A123536/final-report/design/basic_mechanical_scheme.md

# V 型直管检测机器人基本机械方案与第二轮仿真

## 1 结论

当前方案在给定边界内可行，可以进入下一阶段的三维结构设计。

相对上一版，本次将目标管径从 180–220 mm 调整为 140–160 mm，连杆轴间距由 200 mm 缩短为 150 mm，机械限位调整为 90°–125°，合成弹簧刚度由 0.026 提高到 0.029 N·m/deg，并把最小轮管摩擦系数降至 0.15，以覆盖干燥光滑不锈钢管。

修订后的二维准静态仿真覆盖了 140–160 mm 管道内径、干燥不锈钢和 PVC 管道、0.15–0.50 轮管摩擦系数、1.4–1.8 kg 整机质量、10 m 管内行程和 15 m 拖线。模型还计入了全向轮28 mm有限宽度对圆管截面的约束。候选机构没有几何奇异点，三个轮子在全部目标管径内保持接触；在最小轮管摩擦系数和保守拖线阻力同时出现时，牵引安全系数为 1.36。20 万组不确定参数扫描未出现负牵引余量。

这一结论表示修订方案通过第二轮几何和受力筛选，不等于完成物理样机验证。下一阶段仍需进行三维干涉检查、弹簧实测和样机管道试验。

## 2 机构布局

机器人采用单关节对称 V 型结构，从侧面观察为：

```text
主动全向轮 A ---- 150 mm 刚性连杆 ---- 中心被动全向轮及弹簧铰链
                                               \
                                                ---- 150 mm 刚性连杆 ---- 主动全向轮 B
```

实际安装姿态为两个主动轮在管道下侧，中心被动轮在管道上侧。这样布置有三个作用：

1. 电机质量直接增加两个主动轮的法向载荷，提高水平直管内的牵引力。
2. 中心轮及弹簧向上压紧管壁，使三个轮子持续接触。
3. 重心位于管轴下方，能够被动恢复竖直姿态，降低全向轮横向滚子导致的绕管轴漂移。

前后电机分别布置在机构纵向中心面的左右两侧，电子元件置于中心面附近，以抵消横向偏载。必要时可在连杆侧面增加不连续接触的低摩擦防翻限位块，但不增加新的承载轮。

## 3 主要尺寸

| 项目 | 初步设计值 |
|---|---:|
| 适配管道内径 | 140–160 mm |
| 全向轮直径 | 60 mm |
| 单根连杆轴间距 | 150 mm |
| 中心 V 角机械限位 | 90°–125° |
| 目标整机质量 | 1.6 kg |
| 允许整机质量上限 | 1.8 kg |
| 目标巡航速度 | 0.15 m/s |
| 首版管内行程 | 10 m |
| 拖线总长 | 15 m |

机械限位对应的理论管径范围约为 129–166 mm，因此目标范围两端均留有角度余量。插入管道前，将机构张开到 125°并用可拔锁销固定，使径向尺寸小于 140 mm；放入管道后拔出锁销，弹簧驱动 V 角减小并压紧管壁。离开管道后，90°限位防止机构突然完全闭合。

### 管径变化下的几何状态

| 管径 | V 型夹角 | 两主动轮轴距 | 含轮外廓总长 |
|---:|---:|---:|---:|
| 140 mm | 118.1° | 257.3 mm | 317.3 mm |
| 150 mm | 108.8° | 243.9 mm | 303.9 mm |
| 160 mm | 98.9° | 227.9 mm | 287.9 mm |

## 4 中心关节和弹簧

中心被动轮与 V 型铰链共轴。轮子通过轴承自由旋转，两根连杆绕同一根中心轴转动。铰链左右两侧各安装一根镜像扭簧，使载荷对称并避免单侧弹簧引起连杆扭转。

弹簧系统目标参数：

| 参数 | 目标值 |
|---|---:|
| 弹簧数量 | 2 根，左右镜像 |
| 单根等效刚度 | 0.0145 N·m/deg |
| 合成刚度 | 0.029 N·m/deg |
| 等效自由角 | 0° |
| 单根最大工作转矩 | 约 1.72 N·m |
| 单根按 1.5 安全系数选型 | 不低于 2.6 N·m |
| 工作角范围 | 约 99°–118° |

这里的 0° 是装配后的等效自由角，可以通过弹簧腿安装孔的索引位置实现，并不强制要求弹簧实物的自由腿夹角为 0°。

仿真得到的合成弹簧转矩为 2.87–3.42 N·m，中心轮压壁力为 50.33–53.24 N。该压壁力约为 5.1–5.4 kgf，能够通过双手压缩并使用锁销完成装入。相比上一版提高压壁力，是为了覆盖较光滑的干燥不锈钢内壁。

## 5 主动轮传动模块

每个主动轮使用一台已选定的 JGB37-520-12100-EN 电机。采用往届模型已有的模数 1、25/40 齿圆柱齿轮构成 1.6:1 外置减速级：

- 电机轴：25 齿、模数 1、φ6 mm D 形孔。
- 轮轴：40 齿、模数 1、φ8 mm 孔。
- 理论中心距：32.5 mm。
- 仿真按 90% 齿轮效率计算。
- 轮轴使用独立的 φ8 mm 钢轴和两只 619/8 轴承支撑，避免将管壁预紧力直接施加到电机减速箱输出轴上。

前后传动模块互为镜像，使两个电机的横向质量相互平衡。齿轮应设置防护罩，避免拖线、灰尘或后续摄像头线束进入啮合区。

### 传动后的性能

| 项目 | 结果 |
|---|---:|
| 轮端空载转速 | 68.75 rpm |
| 理论空载车速 | 0.216 m/s |
| 轮端额定转速 | 53.1 rpm |
| 理论额定车速 | 0.167 m/s |
| 0.15 m/s 时电机转速 | 76.4 rpm |
| 两电机连续理论驱动力 | 28.24 N |

目标巡航速度 0.15 m/s 位于额定速度以内，适合编码器闭环控制，也为后续摄像检查保留降速空间。

## 6 电机驱动器和拖线供电

TB6612 不再作为正式方案。虽然电机额定电流 0.65 A 处于其连续能力内，但单电机堵转电流达到 2.4 A，无法满足可靠堵转保护需求。

正式方案选用双路 MC33926 驱动板：

- 5–28 V 电机电源；
- 每通道约 3 A 连续、5 A 峰值；
- 两个通道分别控制两台电机；
- 带电流检测、过流和过温保护；
- 单台电机 2.4 A 堵转电流位于驱动器连续能力范围内。

参考：[Pololu Dual MC33926 Motor Driver Carrier](https://www.pololu.com/product/1213)。若采购困难，Cytron MDD3A 可作为第二选择，但应另加电流检测。

为减少 15 m 拖线压降，建议在地面端提供 24 V，在机器人端使用 12 V、至少 6 A 的降压模块为电机驱动器供电。控制器和编码器在机器人端处理，只通过 RS-485 沿拖线传输控制与状态数据。这样比直接在长线末端输送 12 V 更适合后续延长行程。

## 7 仿真模型

定义：

- 管道内径为 `D`；
- 轮半径为 `r`；
- 两相邻轮轴之间的连杆长度为 `L`；
- 全向轮宽度为 `w`；
- 单个轮轴相对管道中心的径向偏置为 `z`；
- 中心轮与主动轮中心之间的径向距离为 `h=2z`；
- 单侧轴向跨度为 `a`；
- V 型夹角为 `β`。

几何关系为：

```text
z = sqrt((D/2)^2 - (w/2)^2) - r
h = 2z
a = sqrt(L² - h²)
β = 2 arccos(h/L)
```

合成弹簧转矩为：

```text
M = k(β - β0)
```

忽略连杆自重对局部力矩的小影响，每根连杆关于中心轴的力矩平衡给出：

```text
N_outer × a = M
N_center = 2M/a
```

两个下侧主动轮承担的总法向力近似为：

```text
N_drive = N_center + mg
```

可用牵引力取轮管静摩擦极限与电机连续输出极限中的较小值：

```text
F_traction = min(μ N_drive, F_motor_continuous)
```

拖线阻力按拖入管内的线缆质量和滑动摩擦计算，并叠加机器人滚动阻力。材料工况采用保守区间，而不是把某个手册摩擦系数当作固定值：

- 干燥不锈钢管按 `μ=0.15–0.30` 检查，其中 0.15 为光滑表面的设计下限；
- 干燥 PVC 管按 `μ=0.25–0.50` 检查；
- 全局不确定性扫描使用 `μ=0.15–0.50`。

实际摩擦系数会随全向轮滚子材料、表面粗糙度和灰尘变化，样机阶段必须通过斜坡法或拉力计实测。保守工况使用：

- 轮管摩擦系数 0.15；
- 拖线线密度 0.12 kg/m；
- 拖线摩擦系数 0.5；
- 机器人滚动阻力系数 0.08；
- 整机质量 1.8 kg；
- 管内拖线长度 10 m。

## 8 第二轮仿真结果

### 接触与牵引

| 项目 | 结果 |
|---|---:|
| 中心轮压壁力 | 50.33–53.24 N |
| μ=0.15 时最小可用牵引力 | 9.90 N |
| 10 m 标称总阻力 | 3.53 N |
| 10 m 保守总阻力 | 7.30 N |
| 标称安全系数 | 2.70 |
| 保守安全系数 | 1.36 |
| 标称单电机估算电流 | 0.22 A |
| 保守单电机估算电流 | 0.30 A |

最不利工况下，牵引力主要受轮管摩擦限制，而不是受电机额定转矩限制。正常匀速运行时电机电流远低于 0.65 A 额定值。启动阶段仍应采用约 1 s 的 PWM 斜坡，防止全向轮瞬时打滑。

### 不确定性扫描

使用 20 万组随机参数进行扫描：

- 管径 140–160 mm；
- 整机质量 1.4–1.8 kg；
- 轮管摩擦系数 0.15–0.50；
- 弹簧刚度误差 ±10%；
- 等效自由角误差 0–5°；
- 拖线线密度 0.05–0.12 kg/m；
- 拖线摩擦系数 0.2–0.5；
- 滚动阻力系数 0.03–0.08。

结果：

- 牵引余量大于零的比例：100%；
- 安全系数不低于 1.2 的比例：100%；
- 安全系数不低于 1.5 的比例：99.995%；
- 安全系数第 1 百分位：2.04；
- 最小抽样牵引余量：2.77 N。

## 9 第二轮判定

| 检查项 | 判定 |
|---|---|
| 140–160 mm 管径几何适应 | 通过 |
| V 角限位余量 | 通过 |
| 三轮持续压壁 | 通过 |
| 最小摩擦工况牵引 | 通过 |
| 干燥不锈钢保守摩擦下限 | 通过，按 μ=0.15 |
| 干燥 PVC 工况 | 通过，牵引余量高于不锈钢工况 |
| 10 m 保守拖线阻力 | 通过，安全系数 1.36 |
| 电机连续转矩 | 通过，存在明显余量 |
| 电机额定速度 | 通过，传动后约 0.167 m/s |
| 电机驱动器 | TB6612 否决；MC33926 通过 |
| 横向防翻 | 通过布置原则控制，待三维模型确认 |
| 真实弹簧参数 | 待选型和台架实测 |
| 真实管材摩擦 | 已覆盖不锈钢/PVC保守区间，仍需样机实测 |

## 10 尚未开始的下一阶段

本轮只确定了基本机械架构和参数可行性，尚未开始三维零件设计。下一阶段应依次完成：

1. 确定 φ60 全向轮的实际宽度、轮毂孔和滚子材料。
2. 完成中心轮、双扭簧、锁销和机械限位的详细结构。
3. 完成 25/40 齿传动模块及 φ8 轮轴轴承支撑。
4. 在 140 mm 管径下检查电机、齿轮、轮子和外壳的三维包络，横向结构宽度目标不超过 95 mm。
5. 采购或制作弹簧后进行角度－转矩标定。
6. 制作样机并按 140、150、160 mm 三种管径，以及不锈钢和 PVC 两种材料完成牵引和 10 m 行走试验。

## 11 仿真文件

- `simulation/v_pipe_robot_sim.py`：可重复运行的计算脚本。
- `simulation/results/summary.json`：汇总结果。
- `simulation/results/diameter_sweep.csv`：完整管径扫描数据。
- `simulation/results/geometry_and_preload.png`：角度、长度、弹簧转矩与压壁力。
- `simulation/results/geometry_snapshots.png`：三种管径的机构姿态。
- `simulation/results/traction_and_tether.png`：牵引力与拖线阻力。
- `simulation/results/monte_carlo_robustness.png`：20 万组不确定参数扫描。
