A123536/final-report/cad/solidworks/model/HARNESS_PART_MAPPING.txt

Corrected generated harness part names; geometry and transforms are unchanged.
POWER: diameter 4.4 mm; segment lengths 115.6, 61.0, 60.4, 93.3 mm.
SIGNAL: diameter 3.2 mm; segment lengths 114.4, 64.4, 64.1, 93.3 mm.
