A123536/final-report/cad/outputs/annotated_side_layout.png

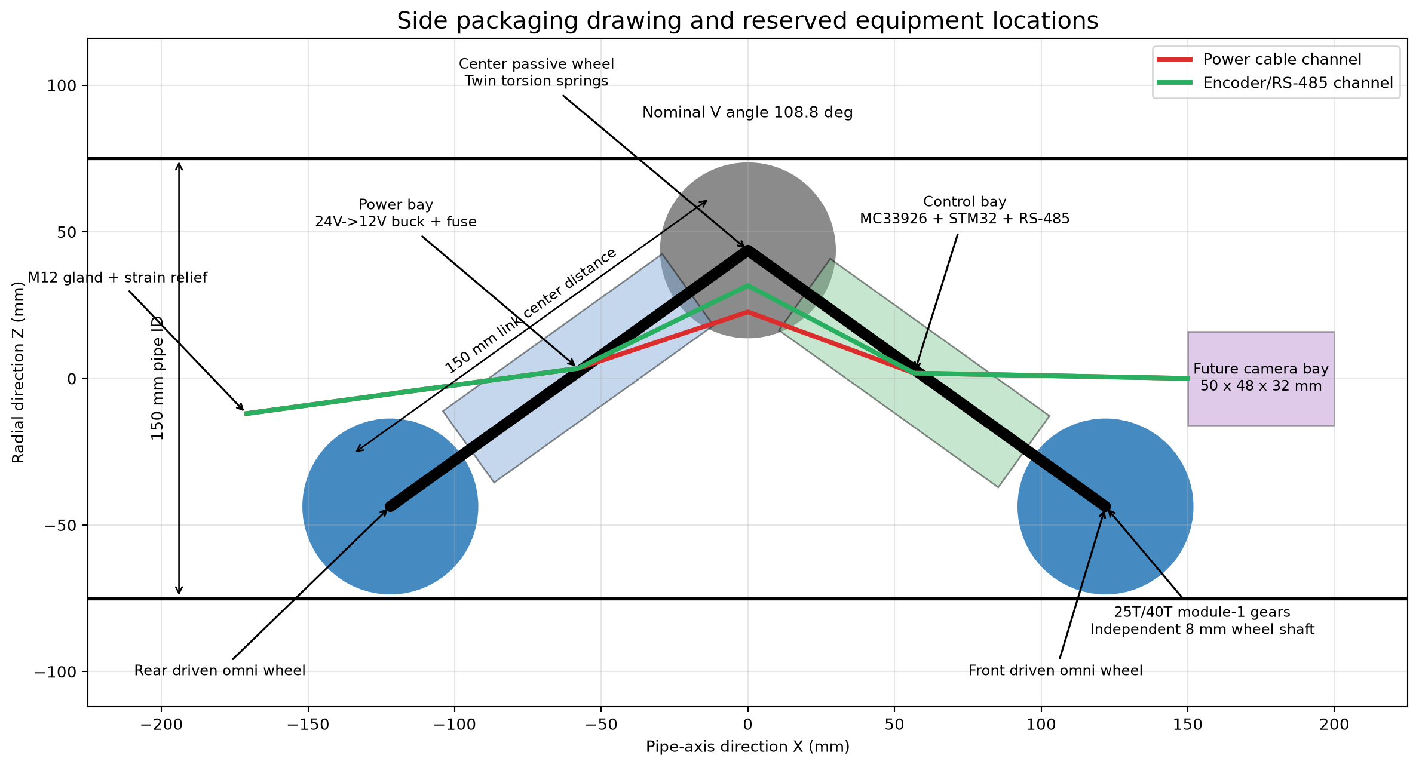
cad/outputs/annotated_side_layout.png
