A123536/final-report/cad/outputs/cross_section_clearance.png

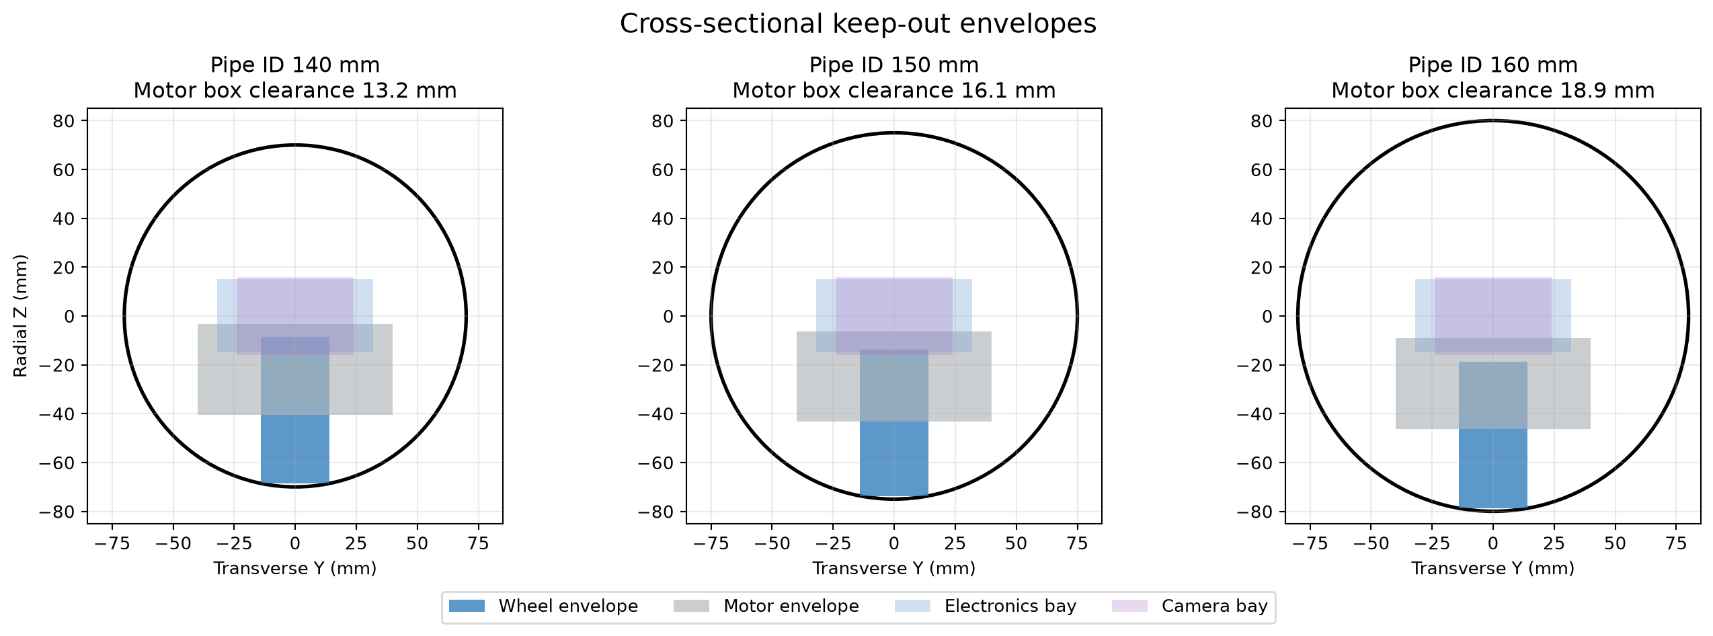
cad/outputs/cross_section_clearance.png
