A123536/final-report/cad/solidworks/model/general_arrangement.png

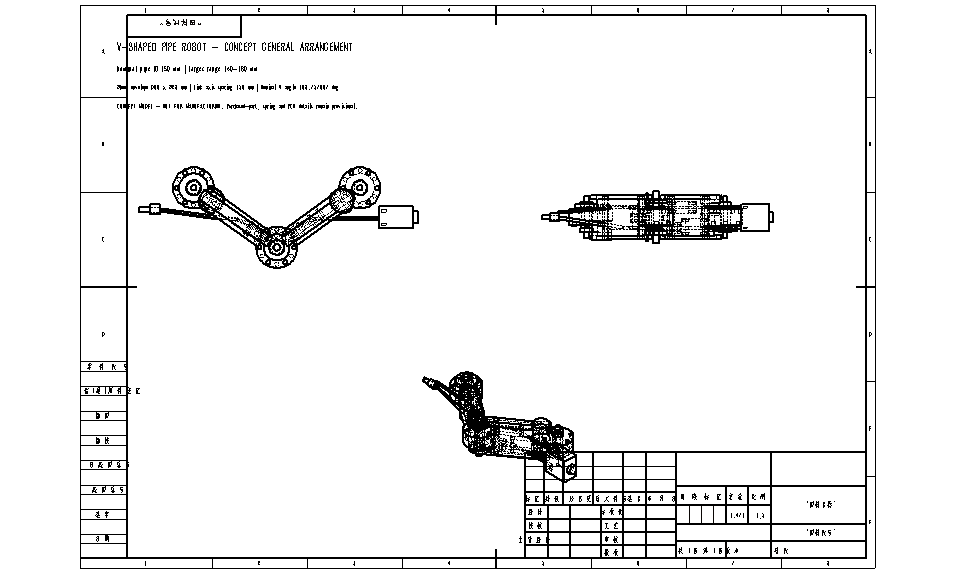
cad/solidworks/model/general_arrangement.png
