A123536/final-report/cad/solidworks/model/overview_robot_only.png

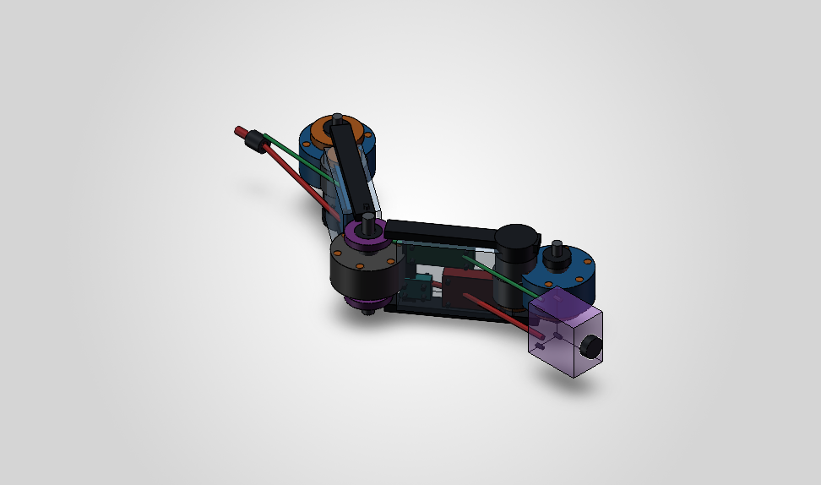
cad/solidworks/model/overview_robot_only.png
