A123536/final-report/cad/solidworks/model/overview_with_pipe.png

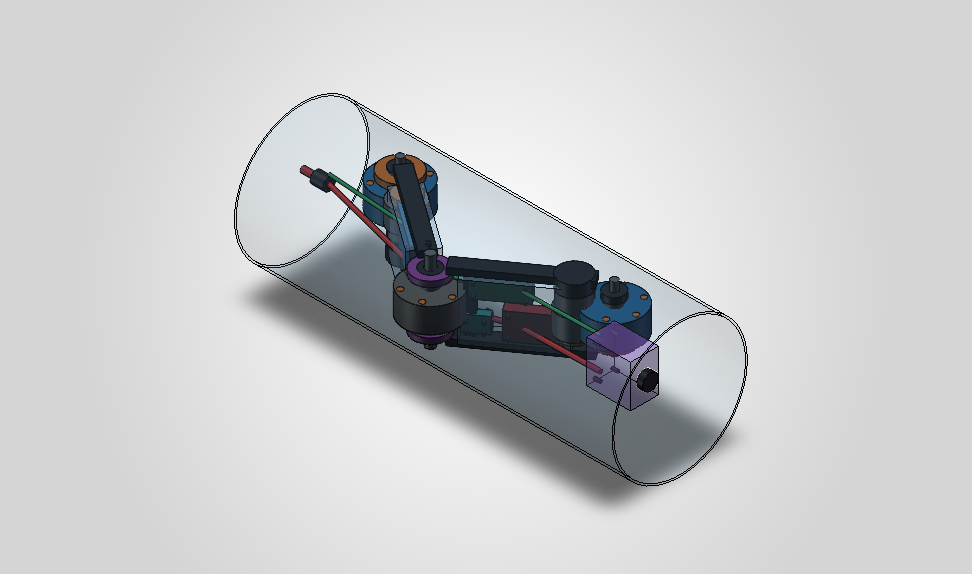
cad/solidworks/model/overview_with_pipe.png
