A123536/final-report/outputs/01a12b65-609a-7bf2-be3d-549e726e3b11/V型管道机器人_完整采购清单_含视觉_2026-10-28.xlsx

Sheet: 采购清单
V型管道机器人完整采购清单（含视觉）
核对日期 | 2026-10-28T00:00:00.000Z |  | 用途：电脑实时看画面、拍照录像，并预留电脑端识别
主购：F411 + MC33926；Luckfox Pico Max + SC3336(B)经有线以太网图传。相机舱须按实物重新设计。
现在买 | 51 | 先确认 | 14 | 图纸后加工 | 13 | 可选 | 9
项目种类 | 87 |  | 已填报价合计（元，非完整预算） | 0.00 |  | 未填单价 | 87
浅黄色列可编辑。已备数量暂填0用于计划，并非实物盘点。报价未填时小计留空，所有型号的现货与到手价均需向商家确认。
编号 | 模块 | 器材 | 推荐型号 / 规格 | 装机用量 | 建议采购 | 已备数量 | 待购数量 | 单位 | 采购阶段 | 采购状态 | 单价（元） | 小计（元） | 关键规格 | 适配与下单说明 | 来源名称 | 厂家资料链接
E01 | 电控 | 运动主控板 | WeAct MiniF4 STM32F411CEU6 V3.1 | 1 | 2 | 0 | 2 | 块 | 现在买 | 未下单 |  |  | 100MHz、3.3V逻辑；整块开发板，不买裸芯片 | 一块装机一块备件；核对F411CE与板上Flash占用 | WeAct MiniSTM32F4x1官方仓库 | https://github.com/WeActStudio/WeActStudio.MiniSTM32F4x1
E02 | 电控 | 双路有刷电机驱动 | Pololu Dual MC33926 Motor Driver Carrier #1213 | 1 | 1 | 0 | 1 | 块 | 现在买 | 未下单 |  |  | 5–28V；约3A连续/路、5A短时峰值；3–5V逻辑 | 约45.7×27.9mm PCB；勿买Arduino/RPi大盾板；封壳需温升测试 | Pololu Dual MC33926 #1213 | https://www.pololu.com/product/1213
E03 | 电控 | STM32下载调试器 | STLINK-V3MINIE 原装 | 1 | 1 | 0 | 1 | 个 | 现在买 | 未下单 |  |  | SWD；USB-C；带STDC14排线 | 若已有可用SWD调试器可扣减；不是量产烧录座 | STLINK-V3MINIE官方资料 | https://www.st.com/en/development-tools/stlink-v3minie.html
E04 | 电控 | SWD转接线 | STDC14 1.27mm转2.54mm SWD转接板/线 | 1 | 1 | 0 | 1 | 套 | 现在买 | 未下单 |  |  | 引出SWDIO/SWCLK/GND/VTref/NRST | 与V3MINIE和MiniF4实际接口核对 | STLINK-V3MINIE官方资料 | https://www.st.com/en/development-tools/stlink-v3minie.html
E05 | 电控 | 机器人RS485收发器 | Waveshare RS485 Board (3.3V)，SP3485 | 1 | 2 | 0 | 2 | 块 | 现在买 | 未下单 |  |  | 3.3V供电与逻辑；显式DE/RE控制 | 一装一备；实测PCB、接线端子高度后调整小板位置 | Waveshare SP3485 3.3V板 | https://www.waveshare.com/rs485-board-3.3v.htm
E06 | 电控 | 电脑USB转RS485 | Waveshare USB TO RS485/422 隔离版 | 1 | 1 | 0 | 1 | 个 | 现在买 | 未下单 |  |  | 二线半双工RS485、隔离电源与信号 | 放在管外；不买RS232冒充RS485；无需再加第二只板做电脑端 | Waveshare隔离USB转RS485/422 | https://www.waveshare.com/wiki/USB_TO_RS485/422
E07 | 电控 | 编码器电平转换 | SN74LVC245A 3.3V转换模块 | 1 | 1 | 0 | 1 | 块 | 现在买 | 未下单 |  |  | 3.3V供电、输入容忍5.5V；至少4路单向 | 先测编码器是推挽还是开漏，再确定接法；不能直接假设5V信号可进所有F411脚 | TI SN74LVC245A | https://www.ti.com/product/SN74LVC245A
E08 | 电控 | USB数据线 | USB-A/USB-C至USB-C，带数据功能 | 2 | 3 | 0 | 3 | 根 | 现在买 | 未下单 |  |  | 短线0.5–1m，供烧录/调试 | 匹配电脑接口；不是15m图传主线 | 本仓库机械/外壳方案 Rev C
E09 | 电控 | RS485终端电阻 | 120Ω、0.25W、1% | 2 | 10 | 0 | 10 | 只 | 现在买 | 未下单 |  |  | 总线物理两端各一只 | 先核对模块内置终端；已有的不能再重复并联 | 本仓库机械/外壳方案 Rev C
E10 | 电控 | 控制载板 | 2.54mm小型洞洞板/定制载板 | 1 | 2 | 0 | 2 | 块 | 现在买 | 未下单 |  |  | 可裁切；装机必须焊接固定 | 先板卡台架验证，再确定载板尺寸与安装孔 | 本仓库机械/外壳方案 Rev C
M01 | 动力传动 | 编码减速电机 | Hiwonder JGB37-520R90-12，带AB编码器 | 2 | 2 | 0 | 2 | 台 | 现在买 | 未下单 |  |  | 12V、90:1、110rpm空载、约85rpm额定、φ6偏心D轴 | 官方版本堵转3.2A，额定转矩2.6kg·cm；不同于旧2.4A假设，必须重定限流/保护并实测安装尺寸 | Hiwonder JGB37-520官方参数 | https://www.hiwonder.com/products/hall-encoder-dc-geared-motor
M02 | 动力传动 | 电机配套6芯线束 | 与所购JGB37编码器配套的原厂插头线 | 2 | 4 | 0 | 4 | 根 | 现在买 | 未下单 |  |  | 2电机线+编码器VCC/GND/A/B | 随电机买；让卖家提供线序/间距，勿凭6芯就盲买JST-PH | Hiwonder JGB37-520官方参数 | https://www.hiwonder.com/products/hall-encoder-dc-geared-motor
M03 | 动力传动 | φ60普通全向轮 | 定制90°全向轮：φ60、轮体宽≤28、φ8轮毂适配 | 3 | 3 | 0 | 3 | 只 | 先确认 | 未下单 |  |  | PU/橡胶滚子；单轮允许径向载荷≥80N约8kgf | 中心轮约53N，按1.5余量询价；现未核实可直接替换商品；不买45°麦克纳姆轮，也不买仅3kg承载Nexus14145 | 航发90度全向轮系列；询问定制，不宣称有直接适配型号 | https://hangfa.com/zh/products/wheels
M04 | 动力传动 | φ8夹紧轮毂 | φ8夹紧式轮毂，法兰孔型按实际全向轮 | 3 | 3 | 0 | 3 | 只 | 先确认 | 未下单 |  |  | 两主动轮传扭，一被动轮连接；匹配轮芯/轴承布置 | 外径、总轴向长度和螺孔未定；不能按旧18×36包络直接认定市售件适配 | 本仓库机械/外壳方案 Rev C
M05 | 动力传动 | 电机25齿齿轮 | m=1、z=25、20°直齿、φ6 D孔、有效齿宽7mm | 2 | 2 | 0 | 2 | 只 | 图纸后加工 | 未下单 |  |  | 建议45钢；毂部尺寸配合电机实际轴伸 | KHK等标准齿轮只能作齿形参照；带长轮毂/10mm齿宽件不能直接塞入现包络 | 本仓库机械/外壳方案 Rev C
M06 | 动力传动 | 25齿惰轮 | m=1、z=25、20°直齿、φ6孔、有效齿宽7mm | 2 | 2 | 0 | 2 | 只 | 图纸后加工 | 未下单 |  |  | 与M05/M07同模数压力角；独立φ6轴和686轴承 | 惰轮在轴上如何转动、轴承装在何处必须由制造图确定 | 本仓库机械/外壳方案 Rev C
M07 | 动力传动 | 40齿轮轴齿轮 | m=1、z=40、20°直齿、φ8孔、有效齿宽7mm | 2 | 2 | 0 | 2 | 只 | 图纸后加工 | 未下单 |  |  | 与轴的夹紧/键/止动结构按图确定 | 轴距25.0与32.5mm；齿宽7mm不是含轮毂总宽 | 本仓库机械/外壳方案 Rev C
M08 | 动力传动 | 主轴轴承 | 619/8-2RS1（SKF）或同尺寸698-2RS | 6 | 8 | 0 | 8 | 只 | 现在买 | 未下单 |  |  | 8×19×6mm，双面密封 | 核对实测三维尺寸；不能替换为608的8×22×7mm | SKF轴承目录：619/8=8×19×6 | https://www.skf.com/binaries/pub12/Images/0901d196802809de-Rolling-bearings---17000_1-EN_tcm_12-121486.pdf
M09 | 动力传动 | 惰轮轴承 | 686-2RS，正规轴承商 | 2 | 4 | 0 | 4 | 只 | 现在买 | 未下单 |  |  | 6×13×5mm | 当前概念每惰轮1只；若制造图改双支撑，用量变4只，备量已覆盖 | 本仓库机械/外壳方案 Rev C
M10 | 动力传动 | φ8轮轴/中心轴 | 45钢精磨轴，按制造图车削 | 3 | 3 | 0 | 3 | 根 | 图纸后加工 | 未下单 |  |  | 概念长74mm×2、92mm×1；轴径8mm | 这些是包络长度；挡圈槽、轴肩、配合公差和最终长度尚不能下加工单 | 本仓库机械/外壳方案 Rev C
M11 | 动力传动 | φ6惰轮轴 | 45钢精磨轴，按制造图车削 | 2 | 2 | 0 | 2 | 根 | 图纸后加工 | 未下单 |  |  | 概念φ6×14mm | 螺纹/止动端和配合待图纸；不要用普通长螺丝光杆替代精密轴颈 | 本仓库机械/外壳方案 Rev C
M12 | 动力传动 | 薄壁轴向调整垫片 | φ8内孔，0.2/0.5/1.0mm混合 | 12 | 30 | 0 | 30 | 片 | 先确认 | 未下单 |  |  | 各厚度10片；外径不碰轴承密封圈 | 确认轴肩与轴承内圈接触后使用 | 本仓库机械/外壳方案 Rev C
M13 | 动力传动 | φ8轴端挡圈 | DIN471 φ8轴用挡圈 | 6 | 20 | 0 | 20 | 只 | 先确认 | 未下单 |  |  | 与最终槽宽/槽径匹配 | 轴端方案未定，先不要在轴上车槽；若采用螺母/轴肩则不买本项 | 本仓库机械/外壳方案 Rev C
S01 | 结构弹簧 | 镜像扭簧 | 定制左旋+右旋各一根 | 2 | 2 | 0 | 2 | 根 | 先确认 | 未下单 |  |  | 每根0.0145N·m/deg；工作约99–118°；验证转矩≥2.6N·m | 索取角度—转矩曲线；OD38/ID12/W6.4只是包络，先由厂家校核线径、圈数、疲劳和装配预紧 | 本仓库机械/外壳方案 Rev C
S02 | 结构弹簧 | 连杆导轨 | 6061-T6，4件，按制造图加工 | 4 | 4 | 0 | 4 | 件 | 图纸后加工 | 未下单 |  |  | 概念122×7×16mm；孔位/关节耳待定 | 当前轨道是实体包络，不是可直接加工的带孔工程图；3mm铝板不等同于7mm厚导轨 | 本仓库机械/外壳方案 Rev C
S03 | 结构弹簧 | 主轴轴承座 | 6061-T6，按619/8和轮轴结构定制 | 6 | 6 | 0 | 6 | 件 | 图纸后加工 | 未下单 |  |  | 3根轴每根左右各1处轴承支撑 | 采购按6个座位计；若合并为整体板则按最终图纸改变零件数 | 本仓库机械/外壳方案 Rev C
S04 | 结构弹簧 | 电机支架 | JGB37法兰匹配支架，6061-T6 | 2 | 2 | 0 | 2 | 件 | 图纸后加工 | 未下单 |  |  | 锁紧孔距/轴伸/偏心量与M01一致 | 要能同时定位电机—惰轮25mm中心距 | Hiwonder JGB37-520官方参数 | https://www.hiwonder.com/products/hall-encoder-dc-geared-motor
S05 | 结构弹簧 | 惰轮支架/轴承座 | 按686轴承和φ6轴定制 | 2 | 2 | 0 | 2 | 套 | 图纸后加工 | 未下单 |  |  | 与轮轴中心距32.5mm | 单边悬臂刚度和轴向止动待设计，不用热熔螺母承受传动轴载荷 | 本仓库机械/外壳方案 Rev C
S06 | 结构弹簧 | 中心铰链/簧腿座 | 6061-T6中心轴套、左右簧腿固定座 | 1 | 1 | 0 | 1 | 套 | 图纸后加工 | 未下单 |  |  | 与中心轴、轴承、轮毂和扭簧成套出图 | 中心扭簧反力不交给2mm PETG电子外壳 | 本仓库机械/外壳方案 Rev C
S07 | 结构弹簧 | 机械限位与锁销座 | 90°/125°限位块与φ4销孔座 | 1 | 1 | 0 | 1 | 套 | 图纸后加工 | 未下单 |  |  | 必须与实际铰链转角一致 | 旧模型限位块相交是装配连接包络，不能直接拿来加工 | 本仓库机械/外壳方案 Rev C
S08 | 结构弹簧 | 装管快拔销 | φ4mm有效长度约40mm，带拉环和防丢绳 | 1 | 2 | 0 | 2 | 支 | 先确认 | 未下单 |  |  | 销长度按最终双耳间距 | 1装1备；不得横穿全向轮或电机 | 本仓库机械/外壳方案 Rev C
S09 | 结构弹簧 | 自加工铝料（备选） | 6061-T6扁条8×20×600mm | 0 | 0 | 0 | 0 | 条 | 可选 | 未下单 |  |  | 仅学校自加工导轨时买；默认外协包料不重复买 | 最终孔位和轴承座仍需制造图；外协报价若含料，取消此项 | 本仓库机械/外壳方案 Rev C
S10 | 结构弹簧 | 电子舱机架夹持件 | 独立夹持座/金属束带，按实物设计 | 1 | 1 | 0 | 1 | 套 | 图纸后加工 | 未下单 |  |  | 固定电源舱、控制舱与相机舱 | 六件外壳只完成舱体自身拼接，机架安装点未放行 | 本仓库机械/外壳方案 Rev C
P01 | 供电保护 | 地面24V电源 | MEAN WELL GST120A24-P1M | 1 | 1 | 0 | 1 | 只 | 现在买 | 未下单 |  |  | 24V/5A/120W封闭桌面电源 | 核对P1M：5.5×2.5mm、中心正；买配套AC线，不用裸露开关电源代替 | MEAN WELL GST120A官方规格 | https://www.meanwell.com/Upload/PDF/GST120A/GST120A-SPEC.PDF
P02 | 供电保护 | 交流输入线 | 正规国标三脚至IEC C13电源线 | 1 | 1 | 0 | 1 | 根 | 现在买 | 未下单 |  |  | 与GST120A的C14插座配套 | 地面使用；按学校/当地供电插座选用成品线 | MEAN WELL GST120A官方规格 | https://www.meanwell.com/Upload/PDF/GST120A/GST120A-SPEC.PDF
P03 | 供电保护 | DC输入转接线 | 5.5×2.5mm母座至XT30U成品线 | 1 | 2 | 0 | 2 | 根 | 现在买 | 未下单 |  |  | 额定≥5A；铜线≥0.75mm²；极性标识 | 不能拿5.5×2.1mm座凑合；负载验收检查接头温升 | MEAN WELL GST120A官方规格 | https://www.meanwell.com/Upload/PDF/GST120A/GST120A-SPEC.PDF
P04 | 供电保护 | 24V转12V降压 | Pololu D42V110F12 #5677 | 1 | 1 | 0 | 1 | 块 | 现在买 | 未下单 |  |  | 固定12V；标称典型9A；PCB43.2×31.8×9mm | 9A条件与散热有关，不是封壳内保证值；在实际20–24V输入下做≥6A负载/温升验证 | Pololu D42V110F12 #5677 | https://pololu.com/product/5677
P05 | 供电保护 | 12V转5V降压 | Pololu D24V50F5 #2851 | 1 | 1 | 0 | 1 | 块 | 现在买 | 未下单 |  |  | 固定5V；典型5A；20.3×17.8×8.8mm | 本项目先按连续3A验收；给F411/视觉/编码器分支供电，未在旧CAD中完整建模 | Pololu D24V50F5 #2851 | https://www.pololu.com/product/2851
P06 | 供电保护 | 地面总保险丝座 | 成品DC保险座，配5A慢断保险 | 1 | 2 | 0 | 2 | 套 | 现在买 | 未下单 |  |  | DC额定≥32V；线径与主线匹配 | 5A是起始选值，按实测浪涌与导线额定最终协调；保险不替代电机电子限流 | 本仓库机械/外壳方案 Rev C
P07 | 供电保护 | 12V电机支路保险 | 成品DC保险座，5A起始测试值 | 1 | 1 | 0 | 1 | 套 | 现在买 | 未下单 |  |  | 两电机共用支路；额定≥32VDC | 新电机双堵转约6.4A，需软件限流/堵转切断；不得靠长时间堵转试保险 | Hiwonder JGB37-520官方参数 | https://www.hiwonder.com/products/hall-encoder-dc-geared-motor
P08 | 供电保护 | 5V逻辑支路保护 | DC小型保险座，配2A/3A保险各一组 | 1 | 1 | 0 | 1 | 套 | 现在买 | 未下单 |  |  | 按视觉启动电流决定最终选值 | 独立于电机支路，防止故障牵连主线 | 本仓库机械/外壳方案 Rev C
P09 | 供电保护 | 保险丝备件 | 5A慢断、2A/3A，与所购座同规格 | 1 | 1 | 0 | 1 | 盒 | 现在买 | 未下单 |  |  | 各5只，DC额定匹配 | 不能把不同尺寸玻璃/插片保险混买 | 本仓库机械/外壳方案 Rev C
P10 | 供电保护 | 地面急停 | 自锁蘑菇头急停+DC额定≥24V/5A触点或成品急停盒 | 1 | 1 | 0 | 1 | 套 | 现在买 | 未下单 |  |  | 切断24V主线；人工复位 | 选额定DC开断能力明确的触点，不能只看250VAC标识 | 本仓库机械/外壳方案 Rev C
P11 | 供电保护 | 驱动输入储能电容 | 低ESR 1000µF/25V或35V电解 | 1 | 4 | 0 | 4 | 只 | 现在买 | 未下单 |  |  | 靠近12V驱动输入；短引线 | 核对电容直径和高度，位置须随载板安排 | 本仓库机械/外壳方案 Rev C
P12 | 供电保护 | 电机抑制电容 | 100nF/50V X7R或薄膜 | 2 | 10 | 0 | 10 | 只 | 现在买 | 未下单 |  |  | 每台电机端子间1只 | 其余用于板卡近端旁路；不要在电机输出并大电解 | 本仓库机械/外壳方案 Rev C
P13 | 供电保护 | 电源连接器 | AMASS XT30U 公母对，正规商家 | 4 | 6 | 0 | 6 | 对 | 现在买 | 未下单 |  |  | 带热缩套；主电源与两路电机连接 | 3.3V/5V信号用不同插头防误插，不能让电源端子承担拖拽力 | 本仓库机械/外壳方案 Rev C
P14 | 供电保护 | 电源分配与开关小板 | 额定≥5A小型端子/焊接分线板 | 1 | 1 | 0 | 1 | 套 | 现在买 | 未下单 |  |  | 区分24V、12V、5V、GND | 装机使用固定焊接/锁紧端子，不用面包板承载电机电流 | 本仓库机械/外壳方案 Rev C
V01 | 视觉图传 | 图传主板 | Luckfox Pico Max（RV1106G3，256MB版本） | 1 | 1 | 0 | 1 | 块 | 现在买 | 未下单 |  |  | 100M以太网、MIPI CSI；与官方Buildroot/rkipc流程配套 | 先用配套系统做RTSP台架测试；含RJ45/插线空间，不能承诺放进原50×48×32mm舱 | Luckfox Pico Pro/Max官方资料 | https://wiki.luckfox.com/Luckfox-Pico-Pro-Max
V02 | 视觉图传 | 配套相机 | Waveshare SC3336 3MP Camera (B) | 1 | 1 | 0 | 1 | 套 | 现在买 | 未下单 |  |  | 2304×1296最高30fps；3.95mm F2.0；手调焦；对角98.3° | 只买Luckfox兼容针脚版本，不是通用树莓派CSI相机；先设1080p/25或30fps测试，不承诺现场帧率 | Waveshare SC3336 Camera B官方说明 | https://www.waveshare.com/wiki/SC3336_3MP_Camera_(B)
V03 | 视觉图传 | CSI排线备件 | SC3336与Luckfox原厂匹配FFC | 0 | 1 | 0 | 1 | 根 | 现在买 | 未下单 |  |  | 与相机同店同版本；长度依安装布局确认 | 本项仅补1根备件，V02套装应已含装机线；不能只凭针数购买同面/异面线 | Waveshare SC3336 Camera B官方说明 | https://www.waveshare.com/wiki/SC3336_3MP_Camera_(B)
V04 | 视觉图传 | 启动/本地录像卡 | SanDisk High Endurance microSD 32GB（或同级） | 1 | 1 | 0 | 1 | 张 | 现在买 | 未下单 |  |  | 正规渠道；系统兼容格式；非必需靠卡传画面 | 板载SPI NAND可启动，卡用于备份/本地缓存；仅插卡不会自动开启录像 | SanDisk High Endurance官方规格 | https://www.sandisk.com/tools/documentRequestHandler
V05 | 视觉图传 | 电脑USB网卡 | TP-LINK UE300 或同级标准USB千兆RJ45网卡 | 0 | 0 | 0 | 0 | 个 | 可选 | 未下单 |  |  | 电脑无RJ45口才买1只；支持100M协商 | 不是USB转TTL，也不是USB转RS485；电脑已有网口则省掉 | TP-LINK UE300官方规格 | https://www.tp-link.com/us/home-networking/usb-converter/ue300
V06 | 视觉图传 | 近端调试网线 | 成品纯铜Cat5e/Cat6 RJ45，1–2m | 1 | 2 | 0 | 2 | 根 | 现在买 | 未下单 |  |  | 先用短线调通画面再换15m拖线 | 普通软跳线只用于台架，不替代反复弯曲拖链线 | Luckfox Pro/Max CSI与图传说明 | https://wiki.luckfox.com/Luckfox-Pico-Pro-Max/CSI-Camera
V07 | 视觉图传 | 白光补光灯板 | 12V恒压白光环形板，外径约30–36mm、内径≥20mm | 1 | 2 | 0 | 2 | 块 | 先确认 | 未下单 |  |  | 自带限流，0.5–1W起；5000–6500K；独立两线供电 | 先量镜头外径；外径可能超过旧32mm前盖，需重画相机壳；SC3336(B)固定孔不供补光电源 | Waveshare SC3336 Camera B官方说明 | https://www.waveshare.com/wiki/SC3336_3MP_Camera_(B)
V08 | 视觉图传 | 补光开关 | AO3400A逻辑电平MOS开关模块 | 1 | 2 | 0 | 2 | 块 | 现在买 | 未下单 |  |  | 确认3.3V输入能驱动；负载12V灯板 | 先直流常亮验证曝光；调光时检查滚动快门条纹 | 本仓库机械/外壳方案 Rev C
V09 | 视觉图传 | 灯板柔光件 | 乳白扩散片/磨砂PC薄片 | 1 | 1 | 0 | 1 | 片 | 先确认 | 未下单 |  |  | 约0.5–1mm，按灯环开孔 | 不遮挡镜头；避免灯光从防护窗直接反射入镜头 | 本仓库机械/外壳方案 Rev C
V10 | 视觉图传 | 镜头保护窗（选配） | 光学透明PC/玻璃片，按最终前盖 | 0 | 0 | 0 | 0 | 片 | 可选 | 未下单 |  |  | 尺寸、厚度和镜头凸出量实测后确定 | 本阶段干燥直管可先不用；不得据此宣称防水防爆 | 本仓库机械/外壳方案 Rev C
C01 | 拖线线束 | 24V拖线电源线 | 高柔纯铜2×0.75mm²拖链线 | 15 | 18 | 0 | 18 | 米 | 现在买 | 未下单 |  |  | 厂商连续弯曲等级明确；额定电流≥5A | 15m使用+3m余量；接头和实际铺设条件下验收压降与温升 | 本仓库机械/外壳方案 Rev C
C02 | 拖线线束 | 以太网图传拖线 | LAPP ETHERLINE FD P CAT.5e 2170289，2×2×AWG26/19 | 15 | 18 | 0 | 18 | 米 | 现在买 | 未下单 |  |  | 两对100Base-TX、约5.9mm外径、约48g/m；或等效连续弯曲Cat5e | 只接RJ45 1/2/3/6数据对；让商家配适合细多股线的接头并做100M测试；不通过网线输送24V | LAPP ETHERLINE FD P CAT.5e官方规格 | https://products.lappgroup.com/online-catalogue/data-communication-systems-for-ethernet-technology/industrial-ethernet-cat5-5e/cables-for-continuous-flexing-a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
C03 | 拖线线束 | RS485拖线 | 120Ω特性阻抗高柔屏蔽双绞线，2对×0.22mm² | 15 | 18 | 0 | 18 | 米 | 现在买 | 未下单 |  |  | 一对A/B；另一对一芯作信号参考，余芯备用 | 电源、视频、485分开；共地/屏蔽接法依最终接线图；不能省略非隔离板参考地 | 本仓库机械/外壳方案 Rev C
C04 | 拖线线束 | 回收绳 | 芳纶绳φ1.5–2mm，供应商额定拉力≥50kgf | 15 | 18 | 0 | 18 | 米 | 现在买 | 未下单 |  |  | 独立固定到金属机架 | 结节会降低强度；手动回收不冲击拉拽，不依靠电缆导体回收机器人 | 本仓库机械/外壳方案 Rev C
C05 | 拖线线束 | 网线接头/护套 | 适配AWG26/19多股、5.9mm线径的屏蔽RJ45 | 2 | 6 | 0 | 6 | 套 | 现在买 | 未下单 |  |  | 与两对网线配套压接并测试线序 | 不用实心网线接头夹细多股线；图传与RS485插头标识分开 | LAPP ETHERLINE FD P CAT.5e官方规格 | https://products.lappgroup.com/online-catalogue/data-communication-systems-for-ethernet-technology/industrial-ethernet-cat5-5e/cables-for-continuous-flexing-a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
C06 | 拖线线束 | 格兰头/应力释放 | M12/M16多规格试装包，按每根线实测外径 | 3 | 6 | 0 | 6 | 只 | 先确认 | 未下单 |  |  | 至少独立处理电源、以太网、RS485的进入和夹持 | 旧CAD单根φ7拖线及单格兰头包络已不足；不要预先只买夹持范围≤5mm的M12 | 本仓库机械/外壳方案 Rev C
C07 | 拖线线束 | 编织保护套 | 轻质可扩张PET编织套，适配三线束外廓 | 15 | 18 | 0 | 18 | 米 | 先确认 | 未下单 |  |  | 可拆或宽松套管，不能让束缚导致局部硬折 | 整束含回收绳/护套需称重；目标≤0.12kg/m，超出须重算牵引，不沿用旧1.36安全系数 | 本仓库机械/外壳方案 Rev C
C08 | 拖线线束 | 柔性短线 | 多股硅胶线AWG20/22，红黑各3m | 1 | 1 | 0 | 1 | 包 | 现在买 | 未下单 |  |  | 机器人内部电源/电机线；电流与长度匹配 | 主15m电源线仍用C01；电机线成对绞合并远离编码器线 | 本仓库机械/外壳方案 Rev C
C09 | 拖线线束 | 信号连接器 | JST-GH 1.25mm 4/6芯成品端子线套装 | 1 | 1 | 0 | 1 | 包 | 现在买 | 未下单 |  |  | 仅用于新做的低电流信号连接 | 不强配电机原厂插座；若无压接钳买成品线 | 本仓库机械/外壳方案 Rev C
C10 | 拖线线束 | 保护/固定耗材 | 热缩管、软护边、号码管、小扎带、粘式底座 | 1 | 1 | 0 | 1 | 套 | 现在买 | 未下单 |  |  | 按机架固定，保留铰链柔性弯曲余量 | 电缆穿壳处加护边；扎带不勒紧光缆/相机FFC或造成锐角折弯 | 本仓库机械/外壳方案 Rev C
F01 | 打印紧固 | 打印耗材 | eSUN PETG，1.75mm，1kg（或同级PETG） | 1 | 1 | 0 | 1 | 卷 | 现在买 | 未下单 |  |  | 已确定FDM+PETG；0.4mm喷嘴基线 | 六件塑料实心体积约82cm³，1kg含试打/废料余量；最终用量以切片为准 | eSUN PETG官方规格 | https://www.esun3d.com/petg-product
F02 | 打印紧固 | M3低圆头螺钉 | ISO7380-1 M3×10 | 8 | 20 | 0 | 20 | 只 | 现在买 | 未下单 |  |  | 头径≤5.7、头高≤1.7mm | 本轮CAD已验证该头部包络；不能拿M3高圆柱头替代 | 本仓库机械/外壳方案 Rev C
F03 | 打印紧固 | M3热熔螺母 | M3、外径约4.6mm、长5mm的热熔嵌件 | 8 | 20 | 0 | 20 | 只 | 现在买 | 未下单 |  |  | 实际厂商建议底孔须接近φ4.2试件范围 | 不同滚花外形不可只看M3；先试孔，必要时改CAD底孔 | CNC Kitchen热熔螺母孔径指导 | https://www.cnckitchen.com/blog/tips-and-tricks-for-heat-set-inserts
F04 | 打印紧固 | 相机盖螺钉 | M2.5×8内六角圆柱头 | 4 | 20 | 0 | 20 | 只 | 现在买 | 未下单 |  |  | 头径≤4.5、头高≤2.5mm | 相机壳改长后孔型也可能调整；20只为小包装备量 | 本仓库机械/外壳方案 Rev C
F05 | 打印紧固 | M2.5热熔螺母 | M2.5、长4–5mm热熔嵌件 | 4 | 20 | 0 | 20 | 只 | 现在买 | 未下单 |  |  | 按φ4.0暂定底孔选型并试打 | 与M3嵌件分袋标记；外径按供应商安装要求 | CNC Kitchen热熔螺母孔径指导 | https://www.cnckitchen.com/blog/tips-and-tricks-for-heat-set-inserts
F06 | 打印紧固 | 内部绝缘支撑 | M2/M2.5/M3尼龙柱、螺母、绝缘垫片混合包 | 1 | 1 | 0 | 1 | 套 | 现在买 | 未下单 |  |  | 4–10mm多种高度 | 板卡实际安装孔未完成，先做可调台架，不强压PCB | 本仓库机械/外壳方案 Rev C
F07 | 打印紧固 | 通用机械螺钉 | M3×6/8/12/16与M4×8/12/16套装 | 1 | 1 | 0 | 1 | 盒 | 先确认 | 未下单 |  |  | 配尼龙锁紧螺母/平垫 | 最终轴承座和电机安装件图纸确定后补齐专用长度，不把通用盒视为已核对的装机BOM | 本仓库机械/外壳方案 Rev C
F08 | 打印紧固 | 金属螺纹防松 | Loctite 243 小瓶或等效中强度金属螺纹胶 | 0 | 0 | 0 | 0 | 瓶 | 可选 | 未下单 |  |  | 仅适用于已确认相容的金属螺纹 | 不涂PETG或热熔嵌件周边；默认用锁紧螺母优先 | 本仓库机械/外壳方案 Rev C
F09 | 打印紧固 | 齿轮防护罩 | 按最终传动尺寸打印/加工 | 2 | 2 | 0 | 2 | 件 | 图纸后加工 | 未下单 |  |  | 避免线束进入两组齿轮啮合区 | 现六件式电子外壳不包含齿轮防护罩，不能漏掉 | 本仓库机械/外壳方案 Rev C
T01 | 调试工具 | 万用表 | 优利德UT139C或同级，学校已有则不买 | 1 | 1 | 0 | 1 | 台 | 可选 | 未下单 |  |  | 测电压、电阻、通断 | 借用实验室工具可扣减采购数量；电机电流测试按量程和保险规范 | UNI-T UT139系列官方规格 | https://meters.uni-trend.com/product/ut139-series
T02 | 调试工具 | 游标/数显卡尺 | 0–150mm，0.01/0.02mm读数 | 1 | 1 | 0 | 1 | 把 | 现在买 | 未下单 |  |  | 实测轴径、孔距、板卡和轮子外廓 | 若已有合格卡尺填已备1；关键轴承配合不能只凭卡尺代替加工检测 | 本仓库机械/外壳方案 Rev C
T03 | 调试工具 | 恒温焊台与嵌件头 | 带热熔螺母安装头的恒温电烙铁 | 1 | 1 | 0 | 1 | 套 | 可选 | 未下单 |  |  | 配无铅焊锡、助焊剂、镊子 | 学校已有焊台只补嵌件头；按PETG/嵌件厂家要求调整温度 | CNC Kitchen热熔螺母孔径指导 | https://www.cnckitchen.com/blog/tips-and-tricks-for-heat-set-inserts
T04 | 调试工具 | 手工具 | 内六角1.5/2/2.5/3mm、螺丝刀、剪线/剥线工具 | 1 | 1 | 0 | 1 | 套 | 可选 | 未下单 |  |  | 配合低圆头螺钉和线束制作 | 工具可借用；JST/RJ45不同端子需要相应压接工具或买成品线 | 本仓库机械/外壳方案 Rev C
T05 | 调试工具 | USB串口 | CP2102N或CH343模块，3.3V TTL | 1 | 1 | 0 | 1 | 块 | 现在买 | 未下单 |  |  | Luckfox串口/STM32日志调试；不能输出5V逻辑 | 若用STLINK-V3MINIE虚拟串口满足两板调试，可不买；不用其5V小引脚供整个视觉板 | 本仓库机械/外壳方案 Rev C
T06 | 调试工具 | 称重工具 | 0.1g读数电子秤，量程≥2kg | 1 | 1 | 0 | 1 | 台 | 可选 | 未下单 |  |  | 称整机与1m完整拖线束 | 整机目标≤1.8kg、完整线束目标≤0.12kg/m；学校有则借用 | 本仓库机械/外壳方案 Rev C
T07 | 实验材料 | 验证用管道 | 内径实测140/150/160mm的PVC直管/透明管段 | 3 | 3 | 0 | 3 | 段 | 先确认 | 未下单 |  |  | 每种先1段约1m；再布置10m试验段 | 按实际内径下单，DN公称口径不等于内径；学校已有试验管先登记 | 本仓库机械/外壳方案 Rev C
T08 | 实验材料 | 摩擦/牵引测量 | 0–100N拉力计或电子测力计 | 1 | 1 | 0 | 1 | 只 | 可选 | 未下单 |  |  | 轮管摩擦、拖缆阻力和牵引力测量 | 测试方法需区分轮载与整机拉力；实验室可借用 | 本仓库机械/外壳方案 Rev C
T09 | 实验材料 | 贴标与标定样片 | 尺寸标尺、棋盘格、可移除裂纹/锈蚀模拟图 | 1 | 1 | 0 | 1 | 套 | 现在买 | 未下单 |  |  | 确认焦距、照明、畸变和电脑识别流程 | 模拟图仅验证流程，不代表真实裂缝检测精度或最小缺陷分辨率 | 本仓库机械/外壳方案 Rev C
T10 | 实验材料 | 10m行走试验管补充段 | 与T07标称150mm段相同实际内径的直管 | 9 | 9 | 0 | 9 | 米 | 先确认 | 未下单 |  |  | 与1m样段组合达到10m有效长度 | 确认学校场地和管材后买；连接处必须同心、无明显台阶，DN不能代替实测内径 | 本仓库机械/外壳方案 Rev C
T11 | 实验材料 | 试验管支撑与连接 | 可调管托、同心连接套及端部保护件 | 1 | 1 | 0 | 1 | 套 | 先确认 | 未下单 |  |  | 按实际10m管道分段确定管托和接头数量 | 场地布置后列明细；不能悬空拖着管段做驱动试验 | 本仓库机械/外壳方案 Rev C

Sheet: 视觉与兼容性
视觉链路与下单前核对
本表选型不代表现有CAD已替换为实物，也不代表现场帧率、温升或牵引已验证。
核对项目 | 当前结论 | 下单或安装动作 | 依据 | 资料链接
图像与控制分开 | SC3336经CSI接Luckfox，再经有线以太网发RTSP到电脑。STM32与电脑经独立RS485传控制和状态。 | 电脑用VLC看图/录像，后续OpenCV或识别程序读同一视频流。图像不经过F411或RS485。 | Luckfox Pro/Max CSI与图传说明 | https://wiki.luckfox.com/Luckfox-Pico-Pro-Max/CSI-Camera
只买一套主视觉 | 主购Luckfox Pico Max + SC3336 3MP(B)。不需要同时购买OpenMV、树莓派或MaixCAM。 | 确认套装包含匹配FFC；用官方支持的系统与相机驱动，先短线调通，再接15m线。 | Luckfox Pico Pro/Max官方资料 | https://wiki.luckfox.com/Luckfox-Pico-Pro-Max
相机舱尺寸 | 原相机舱50×48×32mm仅是预留包络，主板、RJ45插头、排线转弯和灯环均需实测。 | V01/V02可以买来台架测试；E-05/E-06先不按旧STL最终打印，本次不修改CAD。 | 本仓库机械/外壳方案 Rev C
帧率与识别 | SC3336传感器最高2304×1296@30fps；不是已经验证的管内录像帧率或裂缝检测精度。 | 先以1080p、25/30fps为配置目标；录制静止/行走视频，测延迟、丢帧和最小可辨缺陷。 | Waveshare SC3336 Camera B官方说明 | https://www.waveshare.com/wiki/SC3336_3MP_Camera_(B)
照明与近焦 | 管径小且壁面反光，需要近距离调焦和可控白光。相机B固定孔不供补光。 | 灯板独立供电，先调距后定镜头；保留原镜头试验后再决定广角替换，不盲购不兼容M12镜头。 | Waveshare SC3336 Camera B官方说明 | https://www.waveshare.com/wiki/SC3336_3MP_Camera_(B)
驱动板版本 | 原型应选Pololu #1213 Carrier，约45.7×27.9mm PCB；同芯片大盾板尺寸不同。 | 板卡、焊点、插头与线缆全部算入空间；MC33926近3A连续是带条件的能力，封壳需温升测试。 | Pololu Dual MC33926 #1213 | https://www.pololu.com/product/1213
电机不是同名同规格 | 推荐Hiwonder R90-12官方堵转3.2A，和旧方案的2.4A不同。MC33926峰值5A不等于可无限期堵转。 | 重定电流保护和堵转切断；检查偏心轴、轴伸、法兰孔及编码器线序，不能沿用旧电流换算。 | Hiwonder JGB37-520官方参数 | https://www.hiwonder.com/products/hall-encoder-dc-geared-motor
5V编码器电平 | F411是3.3V逻辑，不能推断所有使用的输入脚都容忍5V。 | 确认编码器开漏/推挽类型；SN74LVC245A用3.3V供电，可作为5V推挽到3.3V的单向缓冲。 | TI SN74LVC245A | https://www.ti.com/product/SN74LVC245A
降压不是广告安数 | D42V110F12典型9A的标定条件为42V输入，实际可用电流取决于输入与散热。 | 以实际20–24V输入、至少6A目标负载验收12V电源；5V支路先按3A验收。热缩或灌封会改变散热。 | Pololu D42V110F12 #5677 | https://pololu.com/product/5677
拖线新增视频线 | 选定LAPP两对网线约48g/m，原仿真的完整线束上限为120g/m。 | 电源、485、回收绳和护套合计还需控制在约72g/m内；整束称重后再沿用/重算牵引。 | LAPP ETHERLINE FD P CAT.5e官方规格 | https://products.lappgroup.com/online-catalogue/data-communication-systems-for-ethernet-technology/industrial-ethernet-cat5-5e/cables-for-continuous-flexing-a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
三个进入口 | 原CAD只有单根φ7拖线与单M12格兰头。现增加独立以太网与参考地线。 | 按实际外径选择M12/M16或多孔护线件，并重画进入口与金属应力释放夹。不要把24V直接接到RJ45。 | 本仓库机械/外壳方案 Rev C
全向轮必须先确认 | 中心轮压壁力最大约53.24N；按1.5余量要求单轮约80N允许径向载荷。 | 现未核实φ60/宽≤28/高摩擦滚子/8mm适配全部满足的现货；向厂家询价，不将Nexus14145直接列为合格件。 | 本仓库机械/外壳方案 Rev C
已排除的轮子 | Nexus14145为φ60、宽12mm，但官方仅列3kg承载，且规格表为Nylon+PE滚子。 | 不能因直径相同就买；45°麦克纳姆轮也不替代本项目的90°普通全向轮。 | NEXUS 14145：仅作排除型号的依据 | https://www.nexusrobot.com/product/60mm-aluminum-double-omni-wheel-basic-14145.html
扭簧要定制 | 每根0.0145N·m/deg、约99–118°工作角，需不低于2.6N·m验证转矩。 | 先确认轮毂/轴承/轴套空间，再由厂家确定线径、圈数和簧腿；索取转矩曲线。 | 本仓库机械/外壳方案 Rev C
制造件尚未放行 | 导轨、轴承座、电机座、轴肩槽位与关节簧腿座尚缺制造级尺寸。 | 先买实物验证器件，取得外形图再加工；不把现有实心轨道/齿轮包络直接发去加工。 | 本仓库机械/外壳方案 Rev C
外壳专用紧固件 | M3×10低圆头要求头径≤5.7、头高≤1.7mm。普通高圆柱头会碰编码器。 | M3嵌件暂定底孔4.2mm，M2.5暂定4.0mm；先试打孔与挡舌配合，再打六件外壳。 | CNC Kitchen热熔螺母孔径指导 | https://www.cnckitchen.com/blog/tips-and-tricks-for-heat-set-inserts
已备与报价 | 已备数量初始为0只是采购计划。报价列留空，没有把缺失报价伪装成免费或预算已齐。 | 据实填写已备/状态/含税单价，待购自动扣减；量词不同的数量不混合求总件数。 | 本仓库机械/外壳方案 Rev C
验收与试验范围 | 当前设计面向干燥水平直管，不包含带压运行、燃气防爆或浸水认证。 | 先台架、1m三种内径样段，再做10m拖线试验。所有实际总质量与线束质量要重新登记。 | 本仓库机械/外壳方案 Rev C
