A123536/final-report/cad/solidworks/model/parts/SIGNAL_HARNESS_D3p2_L64p1_2.SLDPRT

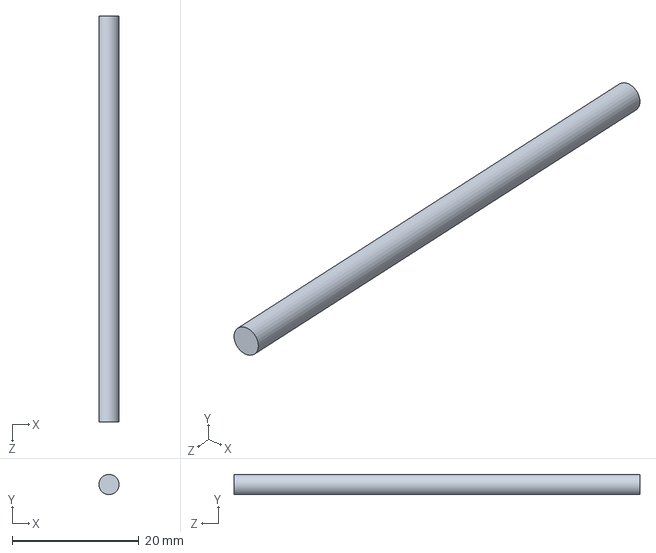
[picture p6: CAD file, 2026-10-13]
cad/solidworks/model/parts/SIGNAL_HARNESS_D3p2_L64p1_2.SLDPRT
3.20 x 3.18 x 64.1 mm
