A123536/final-report/cad/solidworks/model/V_Pipe_Robot_Concept_ID150.STEP

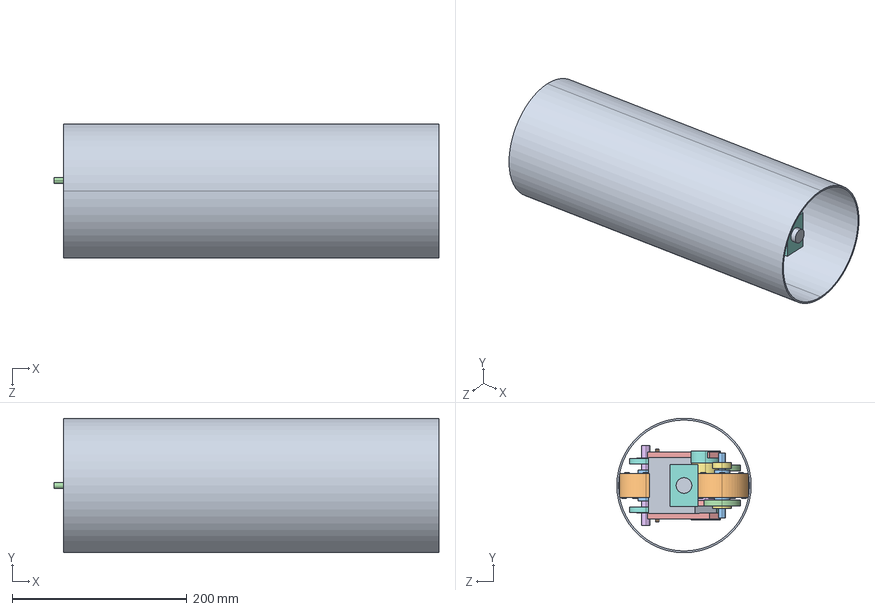
[picture p7: CAD file, 2026-11-03]
cad/solidworks/model/V_Pipe_Robot_Concept_ID150.STEP
441.0 x 154.0 x 154.0 mm
Pipe_ID150_OD154_L430
DrivenWheel_D60_W28 x 2
WheelHub_D18_L36 x 3
OmniRoller_D6_L8 x 36
PassiveWheel_D60_W28
LinkRail_122x7x16 x 4
CenterAxle_D10_L92
BearingEnvelope_22x8x7 x 6
TorsionSpringEnvelope_OD38_ID12_W6p4 x 2
CenterStopTab_12x9x18 x 2
InsertionLockPin_D4_L84
WheelShaft_D8_L74 x 2
Gear40T_m1_Envelope_D42_ID8_W7 x 2
Gear25T_m1_Envelope_D27_ID6_W7 x 2
GearboxEnvelope_D37_L24 x 2
MotorEnvelope_D32p7_L21p7 x 2
EncoderEnvelope_D33p8_L13p8 x 2
EquipmentBay_92x64x30 x 2
Buck24to12_65x42x17
M3Boss_D3p2_L21 x 20
FuseTerminal_24x16x12
MC33926_50x30x12
STM32F411_53x22x10
RS485_25x18x9
FutureCameraBay_50x48x32
CameraLensEnvelope_D18_L7
M3CameraMount_D3p2_L7 x 4
M12GlandEnvelope_D14_L15
ExternalTether_D7_L30
CableTieBridge_10x76x5 x 4
POWER_HARNESS_D4p4_L115p6_0
POWER_HARNESS_D4p4_L61p0_1
POWER_HARNESS_D4p4_L60p4_2
POWER_HARNESS_D4p4_L93p3_3
SIGNAL_HARNESS_D3p2_L114p4_0
SIGNAL_HARNESS_D3p2_L64p4_1
SIGNAL_HARNESS_D3p2_L64p1_2
SIGNAL_HARNESS_D3p2_L93p3_3
