A123536/final-report/cad/solidworks/model/parts/CenterAxle_D10_L92.SLDPRT

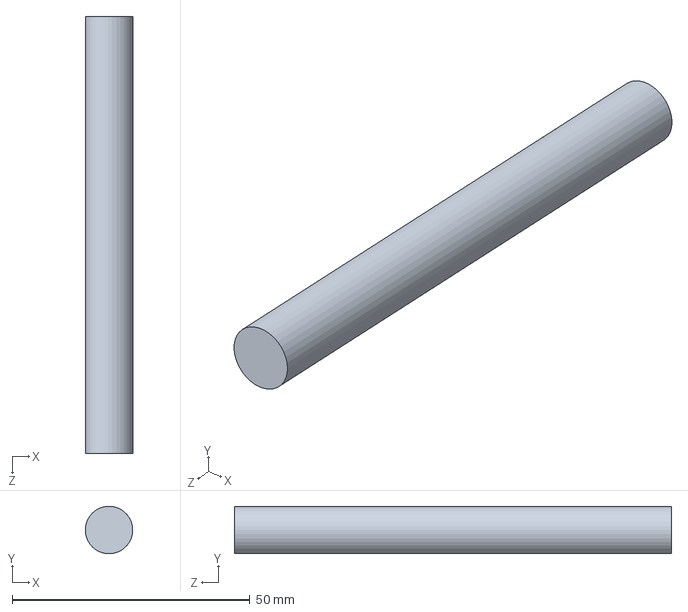
[picture p8: CAD file, 2026-10-13]
cad/solidworks/model/parts/CenterAxle_D10_L92.SLDPRT
10.0 x 9.99 x 92.0 mm
