A123536/final-report/cad/solidworks/model/parts/CenterStopTab_12x9x18.SLDPRT

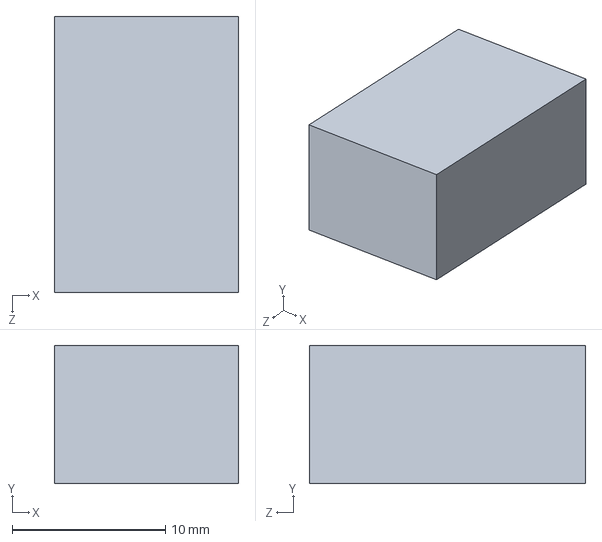
[picture p9: CAD file, 2026-10-13]
cad/solidworks/model/parts/CenterStopTab_12x9x18.SLDPRT
12.0 x 9.00 x 18.0 mm
