A123536/final-report/cad/solidworks/model/parts/Pipe_ID150_OD154_L430.SLDPRT

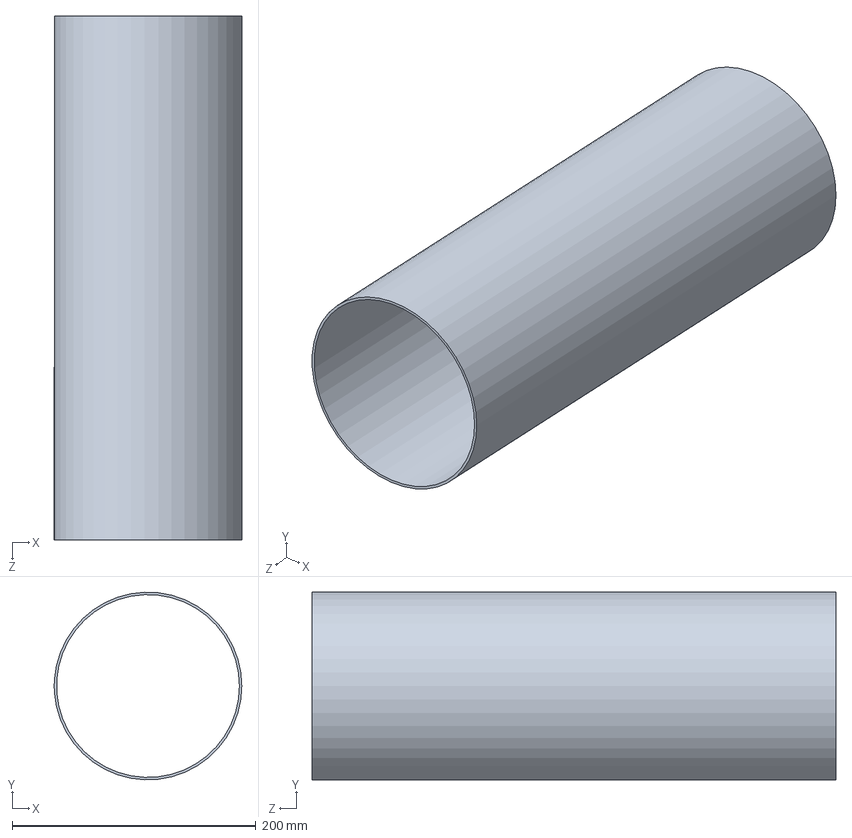
[picture p10: CAD file, 2026-10-13]
cad/solidworks/model/parts/Pipe_ID150_OD154_L430.SLDPRT
154.0 x 153.9 x 430.0 mm
