A123536/final-report/cad/solidworks/model/parts/WheelHub_D18_L36.SLDPRT

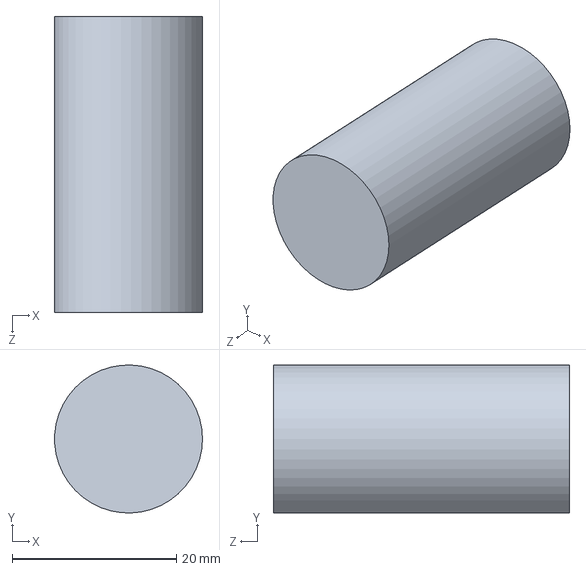
[picture p11: CAD file, 2026-10-13]
cad/solidworks/model/parts/WheelHub_D18_L36.SLDPRT
18.0 x 18.0 x 36.0 mm
