A123536/final-report/cad/solidworks/model/parts/Buck24to12_65x42x17.SLDPRT

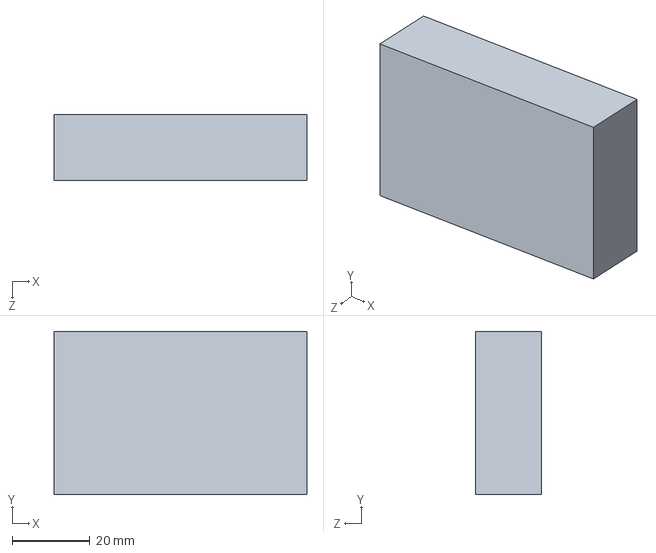
[picture p12: CAD file, 2026-10-13]
cad/solidworks/model/parts/Buck24to12_65x42x17.SLDPRT
65.0 x 42.0 x 17.0 mm
