A123536/final-report/cad/solidworks/model/parts/LinkRail_122x7x16.SLDPRT

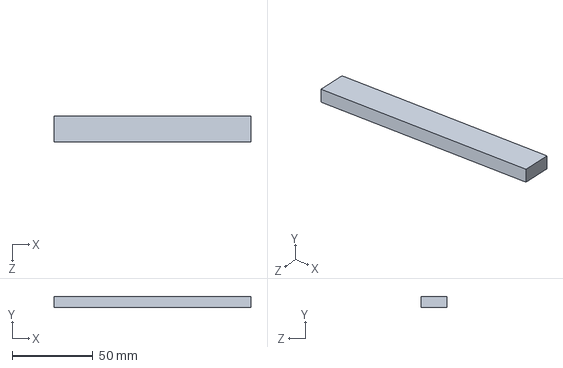
[picture p13: CAD file, 2026-10-13]
cad/solidworks/model/parts/LinkRail_122x7x16.SLDPRT
122.0 x 7.00 x 16.0 mm
