A123536/final-report/cad/solidworks/model/parts/EquipmentBay_92x64x30.SLDPRT

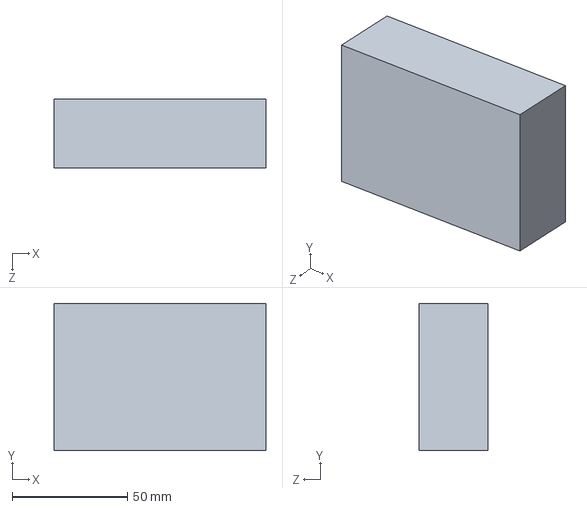
[picture p14: CAD file, 2026-10-13]
cad/solidworks/model/parts/EquipmentBay_92x64x30.SLDPRT
92.0 x 64.0 x 30.0 mm
