A123536/final-report/cad/solidworks/model/parts/CameraLensEnvelope_D18_L7.SLDPRT

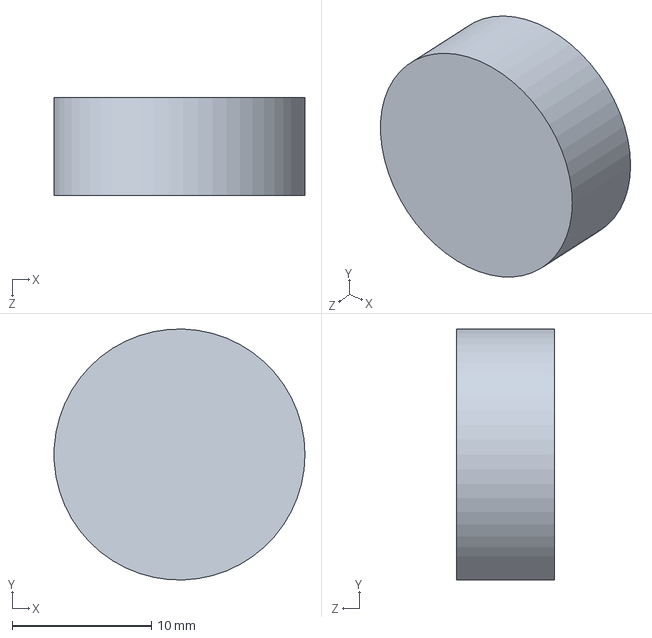
[picture p15: CAD file, 2026-10-13]
cad/solidworks/model/parts/CameraLensEnvelope_D18_L7.SLDPRT
18.0 x 18.0 x 7.00 mm
