A123536/final-report/cad/solidworks/model/parts/RS485_25x18x9.SLDPRT

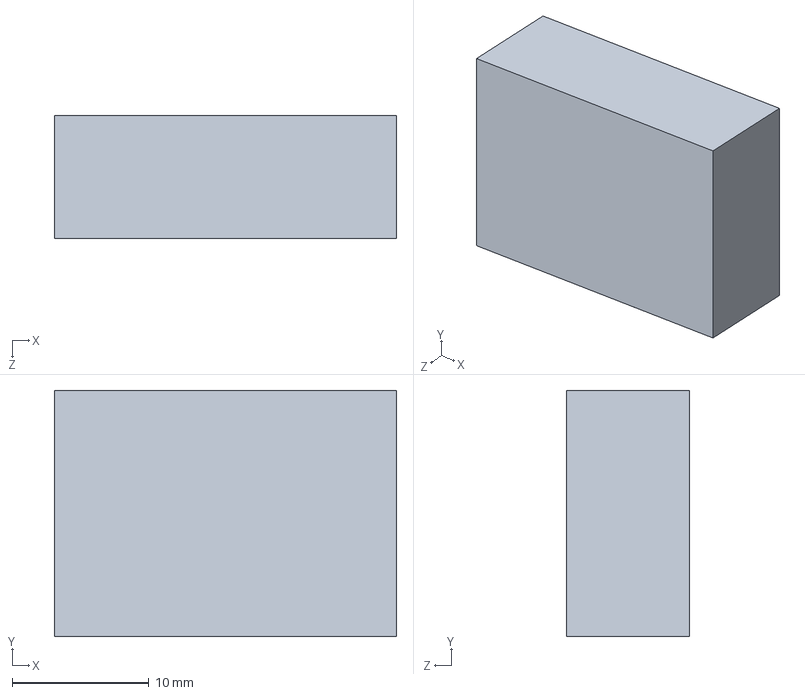
[picture p16: CAD file, 2026-10-13]
cad/solidworks/model/parts/RS485_25x18x9.SLDPRT
25.0 x 18.0 x 9.00 mm
