A123536/final-report/cad/solidworks/model/parts/MotorEnvelope_D32p7_L21p7.SLDPRT

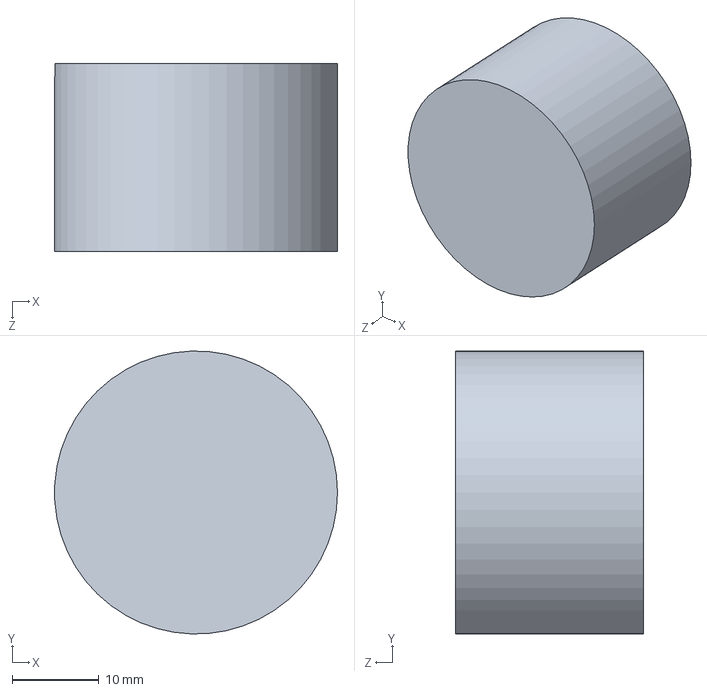
[picture p17: CAD file, 2026-10-13]
cad/solidworks/model/parts/MotorEnvelope_D32p7_L21p7.SLDPRT
32.7 x 32.7 x 21.7 mm
