A123536/final-report/cad/solidworks/model/parts/Gear25T_m1_Envelope_D27_ID6_W7.SLDPRT

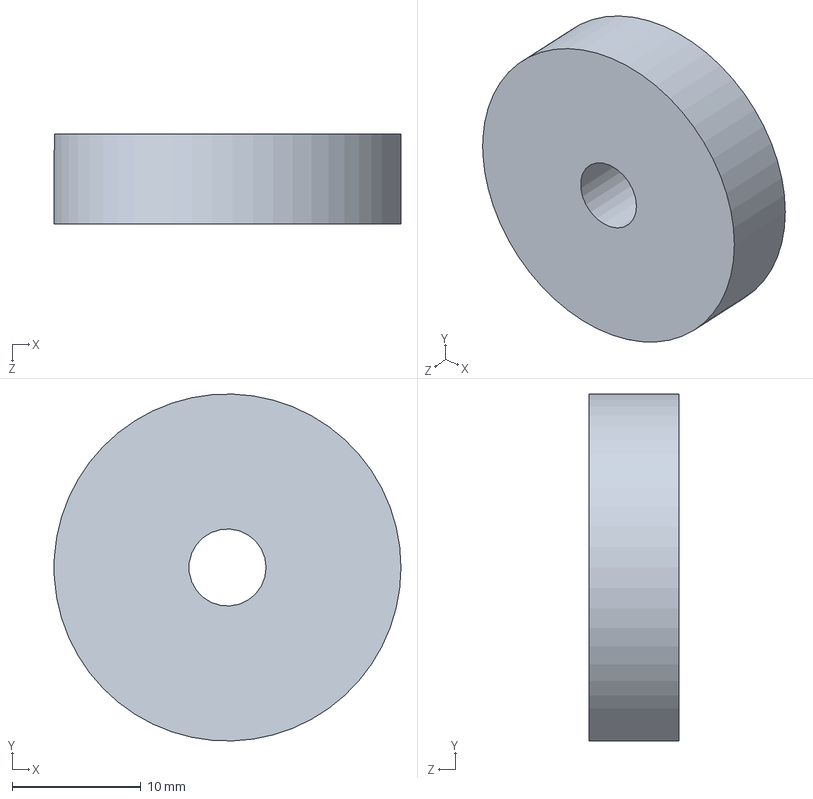
[picture p18: CAD file, 2026-10-13]
cad/solidworks/model/parts/Gear25T_m1_Envelope_D27_ID6_W7.SLDPRT
27.0 x 27.0 x 7.00 mm
