A123536/final-report/cad/solidworks/model/parts/WheelShaft_D8_L74.SLDPRT

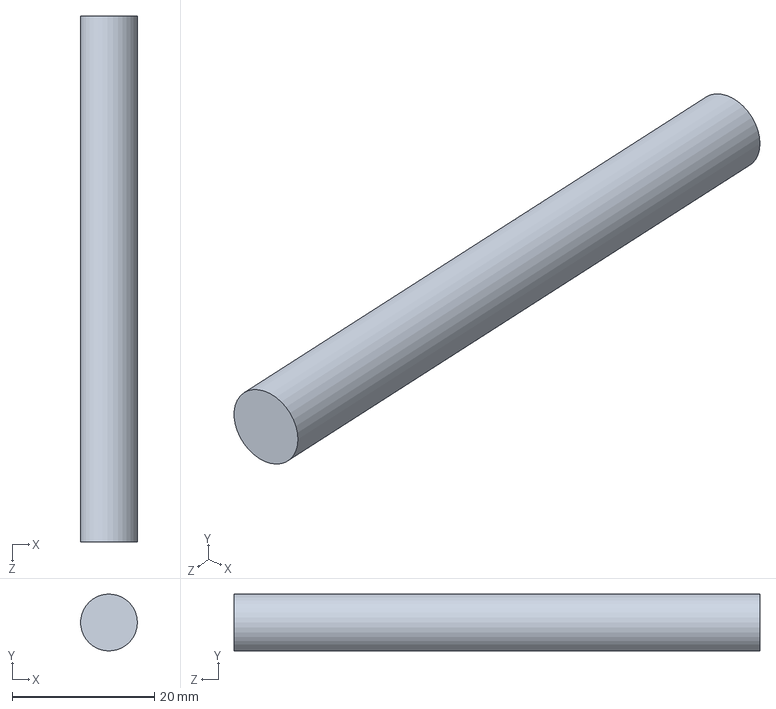
[picture p19: CAD file, 2026-10-13]
cad/solidworks/model/parts/WheelShaft_D8_L74.SLDPRT
8.00 x 7.99 x 74.0 mm
