A123536/final-report/cad/solidworks/model/parts/M3Boss_D3p2_L21.SLDPRT

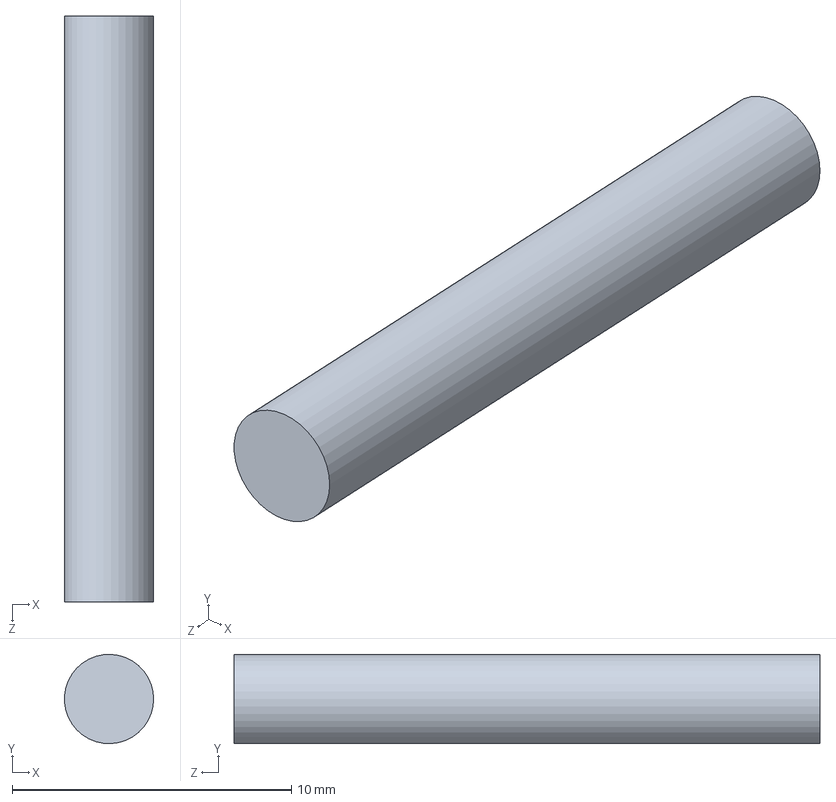
[picture p20: CAD file, 2026-10-13]
cad/solidworks/model/parts/M3Boss_D3p2_L21.SLDPRT
3.20 x 3.20 x 21.0 mm
