A123536/final-report/cad/solidworks/model/parts/CableTieBridge_10x76x5.SLDPRT

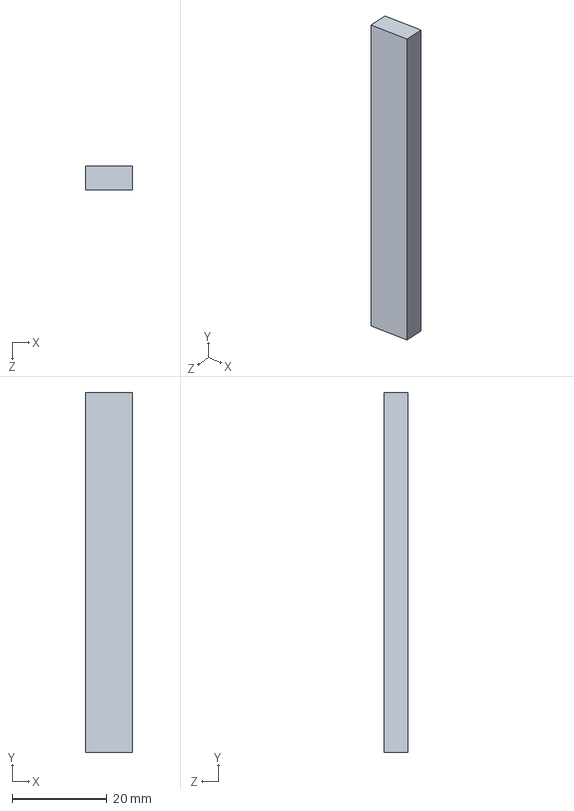
[picture p21: CAD file, 2026-10-13]
cad/solidworks/model/parts/CableTieBridge_10x76x5.SLDPRT
10.0 x 76.0 x 5.00 mm
