A123536/final-report/cad/solidworks/model/parts/FutureCameraBay_50x48x32.SLDPRT

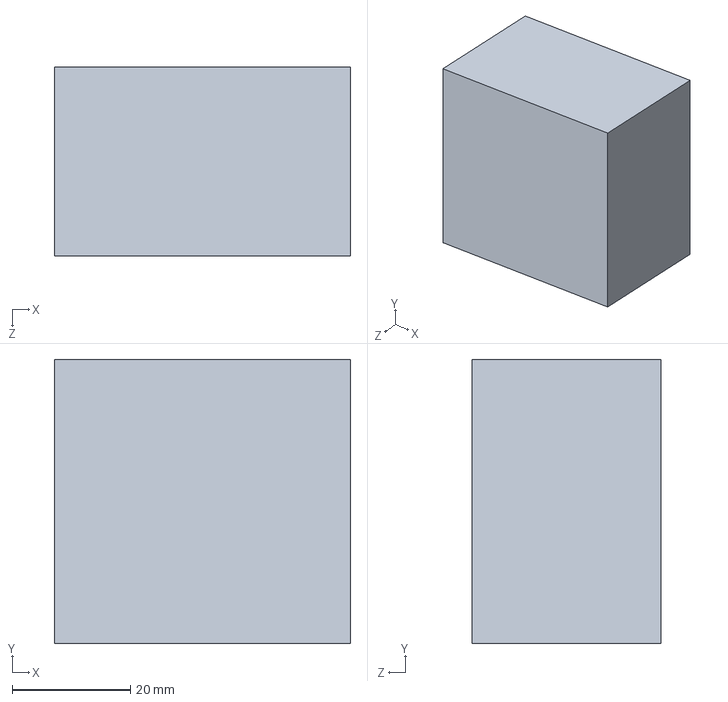
[picture p22: CAD file, 2026-10-13]
cad/solidworks/model/parts/FutureCameraBay_50x48x32.SLDPRT
50.0 x 48.0 x 32.0 mm
