A123536/final-report/cad/solidworks/model/parts/EncoderEnvelope_D33p8_L13p8.SLDPRT

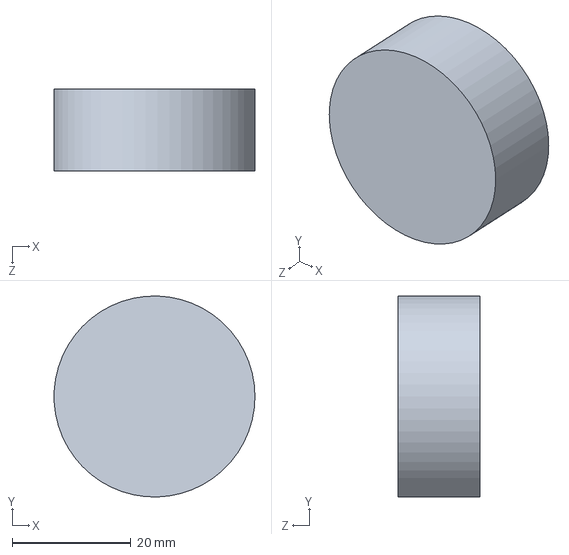
[picture p23: CAD file, 2026-10-13]
cad/solidworks/model/parts/EncoderEnvelope_D33p8_L13p8.SLDPRT
33.8 x 33.8 x 13.8 mm
