A123536/final-report/cad/solidworks/model/parts/POWER_HARNESS_D4p4_L61p0_1.SLDPRT

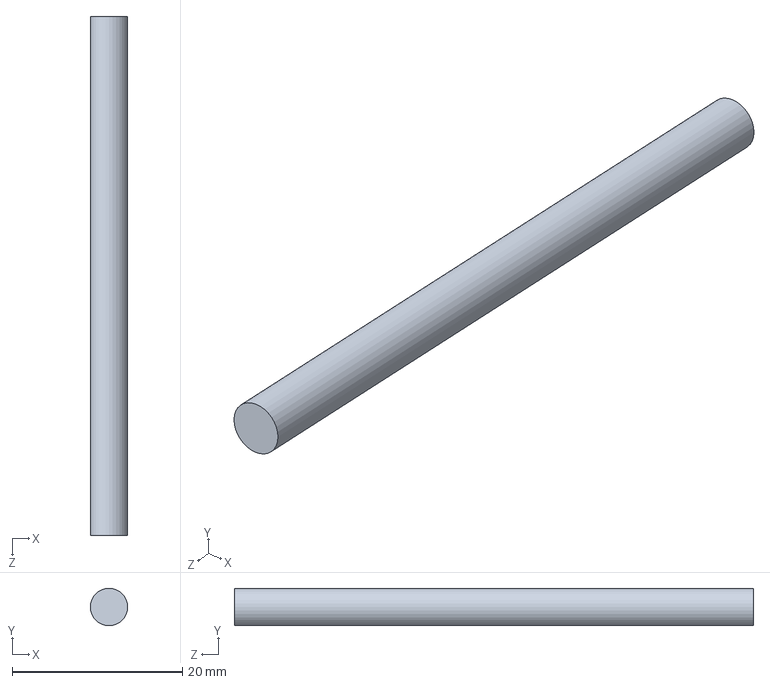
[picture p24: CAD file, 2026-10-13]
cad/solidworks/model/parts/POWER_HARNESS_D4p4_L61p0_1.SLDPRT
4.40 x 4.40 x 61.0 mm
