A123536/final-report/cad/solidworks/model/parts/SIGNAL_HARNESS_D3p2_L93p3_3.SLDPRT

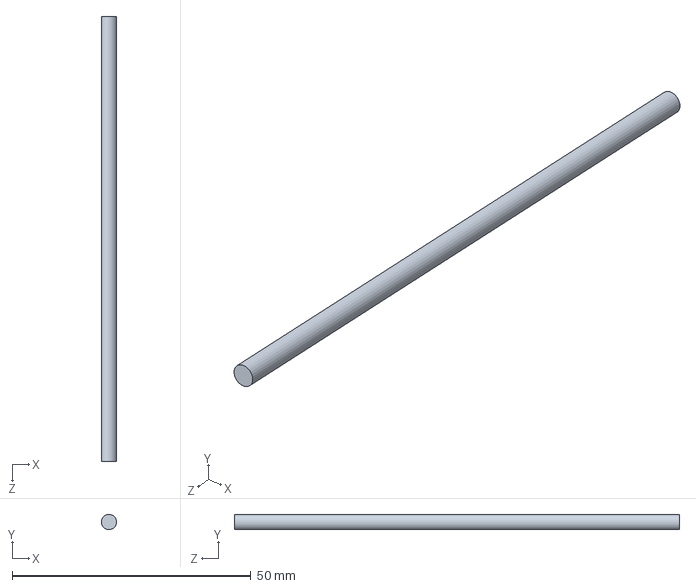
[picture p25: CAD file, 2026-10-13]
cad/solidworks/model/parts/SIGNAL_HARNESS_D3p2_L93p3_3.SLDPRT
3.20 x 3.19 x 93.3 mm
