A123536/final-report/cad/solidworks/model/parts/ExternalTether_D7_L30.SLDPRT

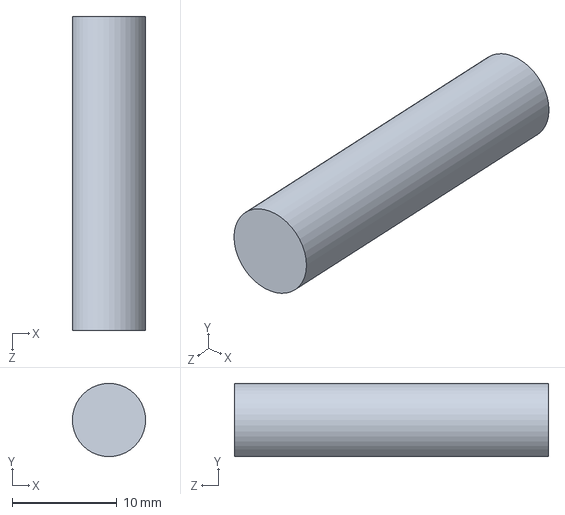
[picture p26: CAD file, 2026-10-13]
cad/solidworks/model/parts/ExternalTether_D7_L30.SLDPRT
7.00 x 7.00 x 30.0 mm
