A123536/final-report/cad/solidworks/model/parts/POWER_HARNESS_D4p4_L93p3_3.SLDPRT

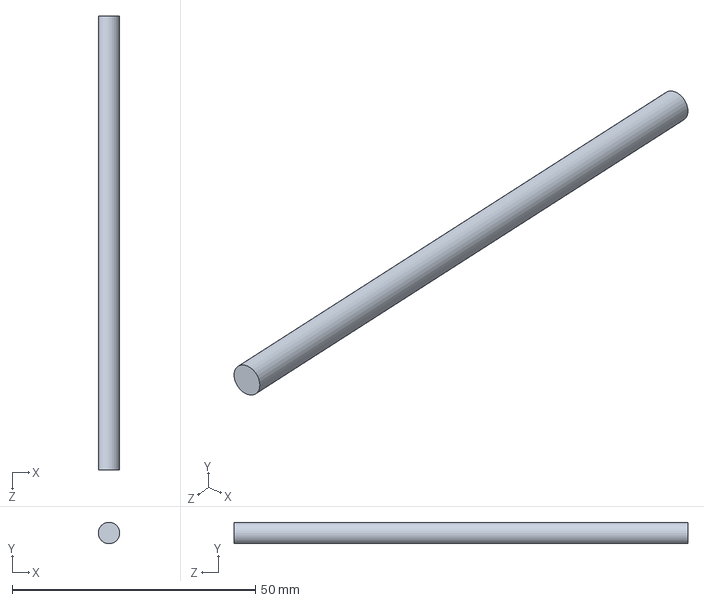
[picture p27: CAD file, 2026-10-13]
cad/solidworks/model/parts/POWER_HARNESS_D4p4_L93p3_3.SLDPRT
4.40 x 4.39 x 93.3 mm
