A123536/final-report/cad/solidworks/model/parts/OmniRoller_D6_L8.SLDPRT

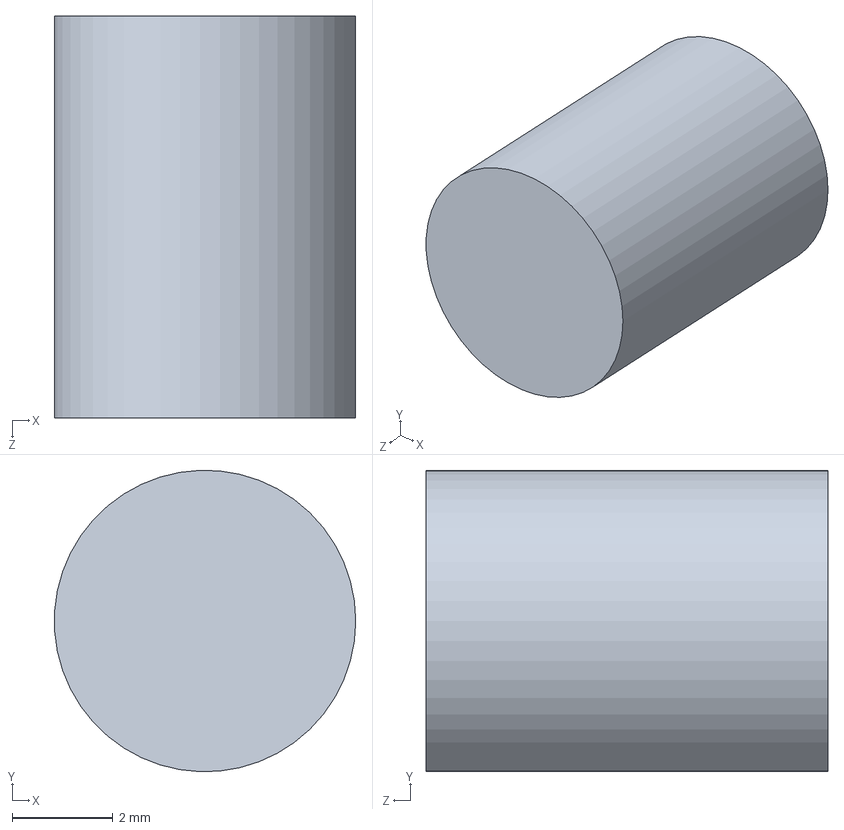
[picture p28: CAD file, 2026-10-13]
cad/solidworks/model/parts/OmniRoller_D6_L8.SLDPRT
6.00 x 6.00 x 8.00 mm
