A123536/final-report/cad/solidworks/model/parts/Gear40T_m1_Envelope_D42_ID8_W7.SLDPRT

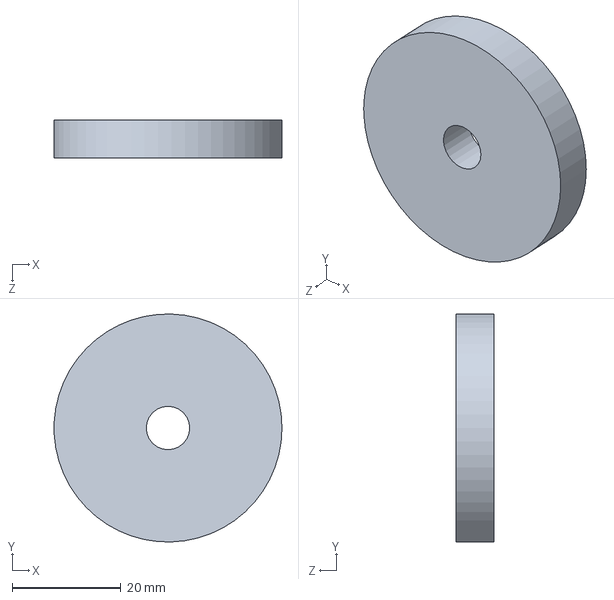
[picture p29: CAD file, 2026-10-13]
cad/solidworks/model/parts/Gear40T_m1_Envelope_D42_ID8_W7.SLDPRT
42.0 x 42.0 x 7.00 mm
