A123536/final-report/cad/solidworks/model/parts/GearboxEnvelope_D37_L24.SLDPRT

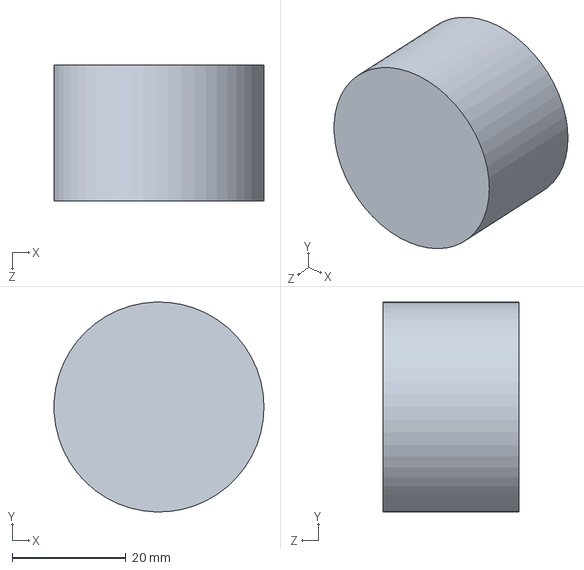
[picture p30: CAD file, 2026-10-13]
cad/solidworks/model/parts/GearboxEnvelope_D37_L24.SLDPRT
37.0 x 37.0 x 24.0 mm
