A123536/final-report/cad/solidworks/model/parts/PassiveWheel_D60_W28.SLDPRT

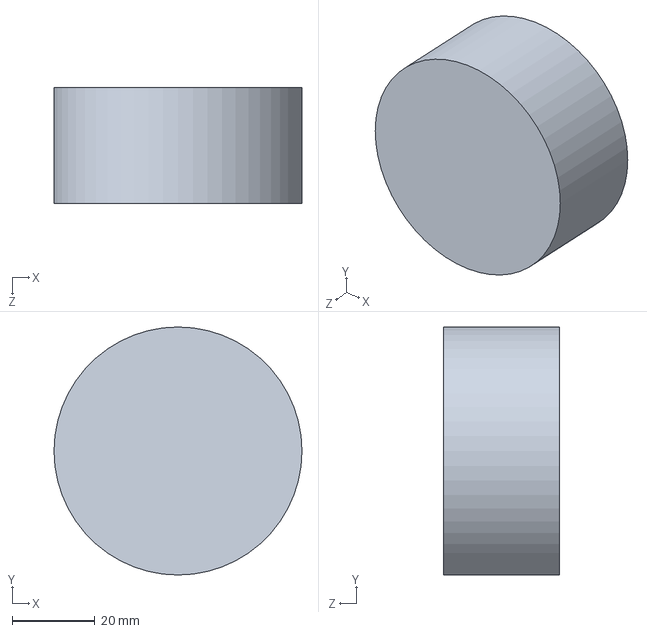
[picture p31: CAD file, 2026-10-13]
cad/solidworks/model/parts/PassiveWheel_D60_W28.SLDPRT
60.0 x 60.0 x 28.0 mm
