A123536/final-report/cad/solidworks/model/parts/M3CameraMount_D3p2_L7.SLDPRT

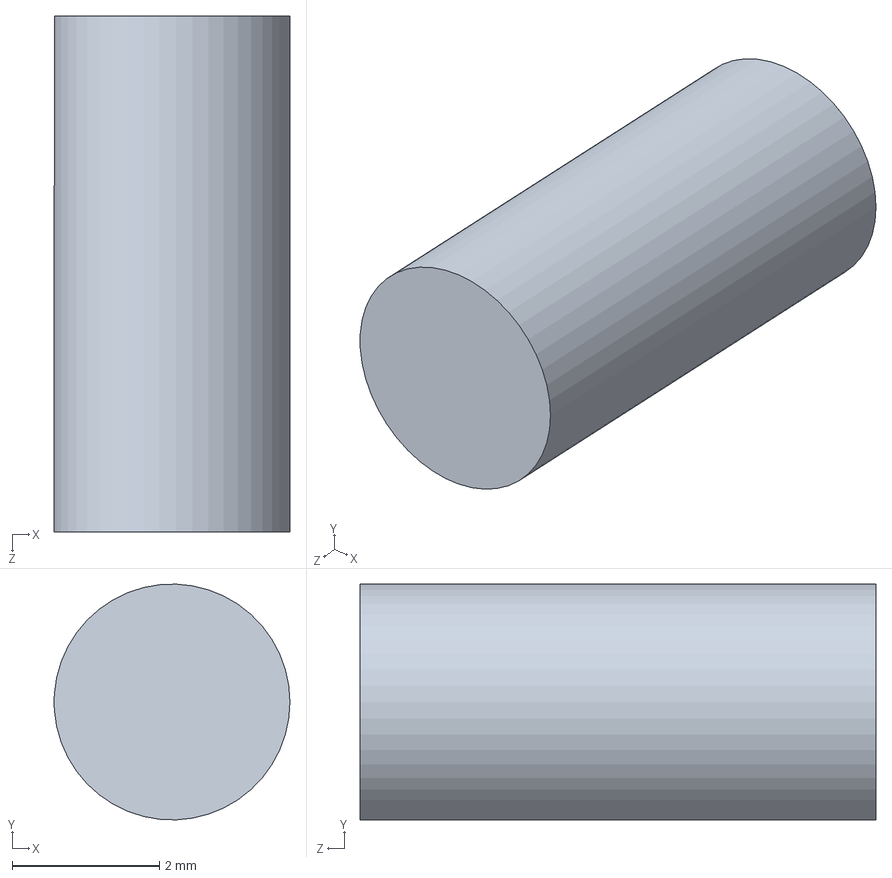
[picture p32: CAD file, 2026-10-13]
cad/solidworks/model/parts/M3CameraMount_D3p2_L7.SLDPRT
3.20 x 3.20 x 7.00 mm
