A123536/final-report/cad/solidworks/model/parts/M12GlandEnvelope_D14_L15.SLDPRT

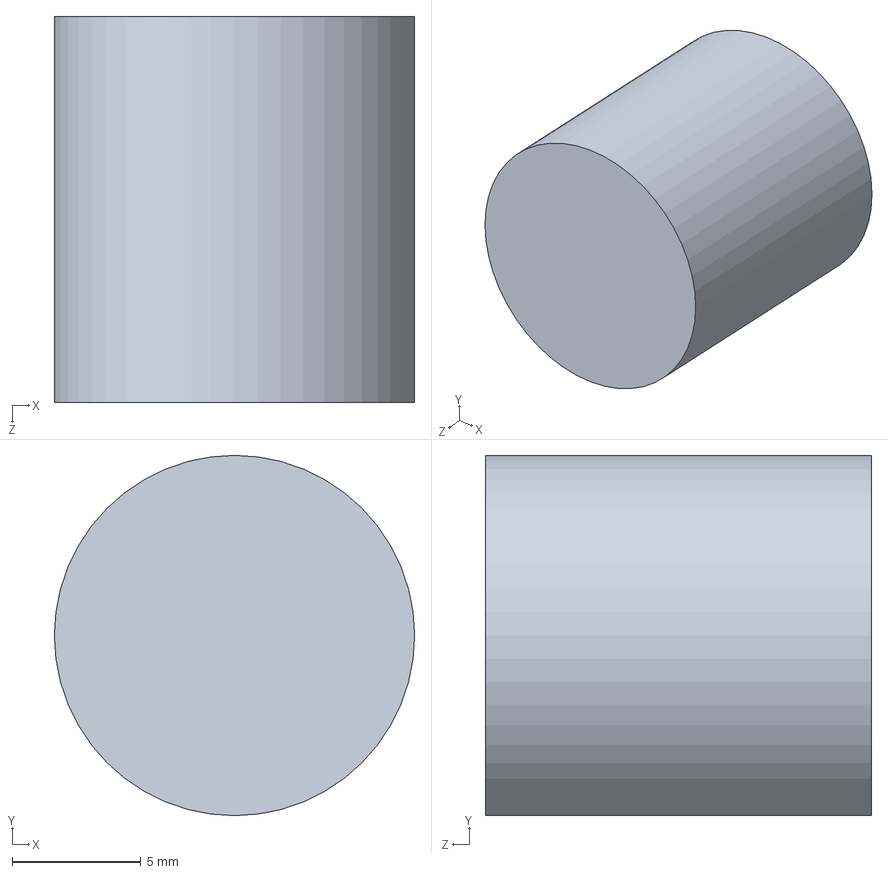
[picture p33: CAD file, 2026-10-13]
cad/solidworks/model/parts/M12GlandEnvelope_D14_L15.SLDPRT
14.0 x 14.0 x 15.0 mm
