A123536/final-report/cad/solidworks/model/parts/STM32F411_53x22x10.SLDPRT

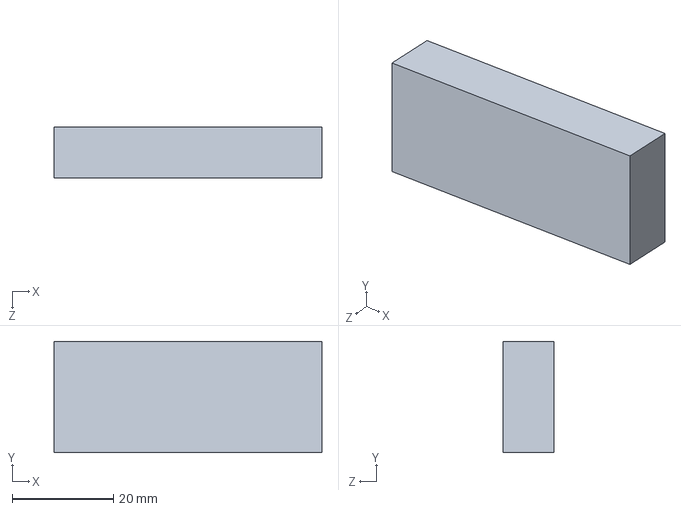
[picture p34: CAD file, 2026-10-13]
cad/solidworks/model/parts/STM32F411_53x22x10.SLDPRT
53.0 x 22.0 x 10.0 mm
