A123536/final-report/cad/solidworks/model/parts/POWER_HARNESS_D4p4_L60p4_2.SLDPRT

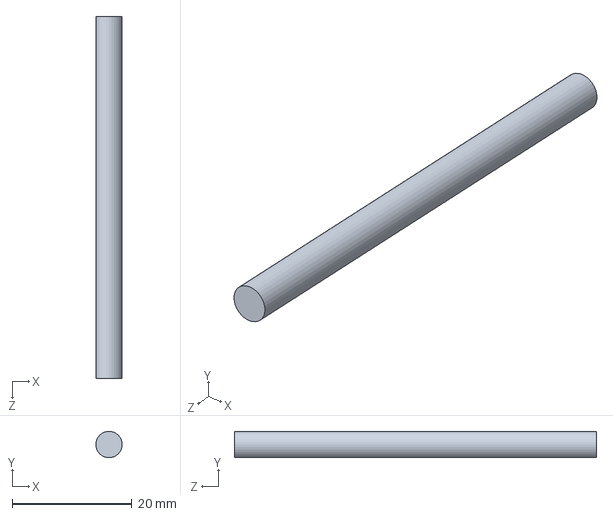
[picture p35: CAD file, 2026-10-13]
cad/solidworks/model/parts/POWER_HARNESS_D4p4_L60p4_2.SLDPRT
4.40 x 4.40 x 60.4 mm
