A123536/final-report/cad/solidworks/model/parts/FuseTerminal_24x16x12.SLDPRT

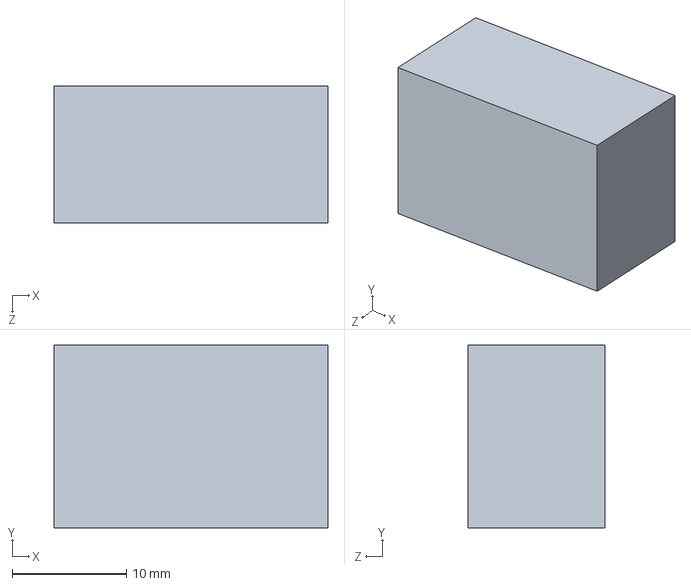
[picture p36: CAD file, 2026-10-13]
cad/solidworks/model/parts/FuseTerminal_24x16x12.SLDPRT
24.0 x 16.0 x 12.0 mm
