A123536/final-report/cad/solidworks/model/parts/POWER_HARNESS_D4p4_L115p6_0.SLDPRT

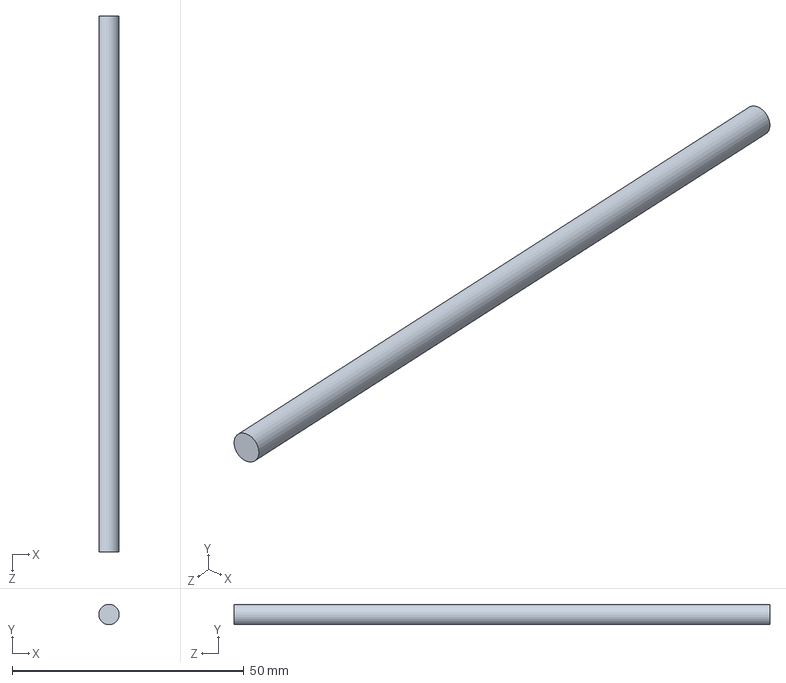
[picture p37: CAD file, 2026-10-13]
cad/solidworks/model/parts/POWER_HARNESS_D4p4_L115p6_0.SLDPRT
4.40 x 4.40 x 115.6 mm
