A123536/final-report/cad/solidworks/model/parts/InsertionLockPin_D4_L84.SLDPRT

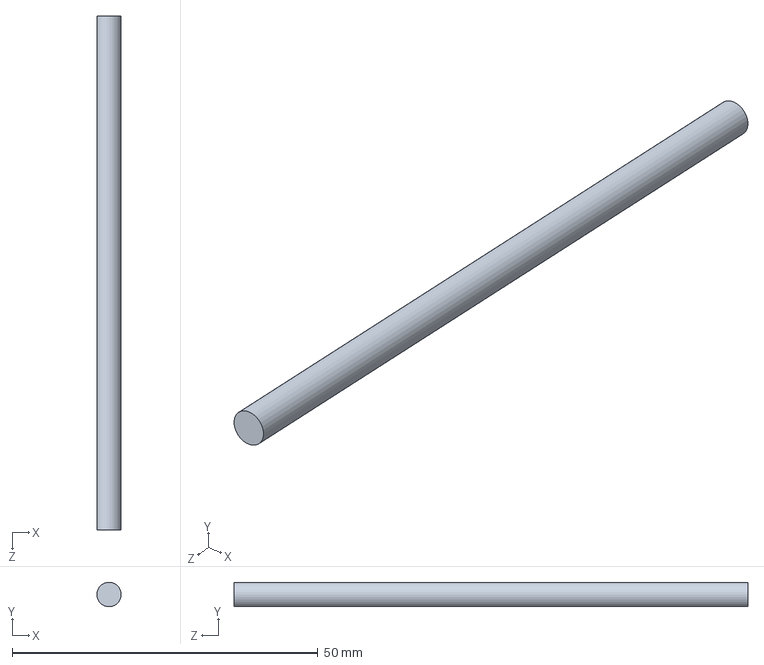
[picture p38: CAD file, 2026-10-13]
cad/solidworks/model/parts/InsertionLockPin_D4_L84.SLDPRT
4.00 x 3.99 x 84.0 mm
