A123536/final-report/cad/solidworks/model/parts/BearingEnvelope_22x8x7.SLDPRT

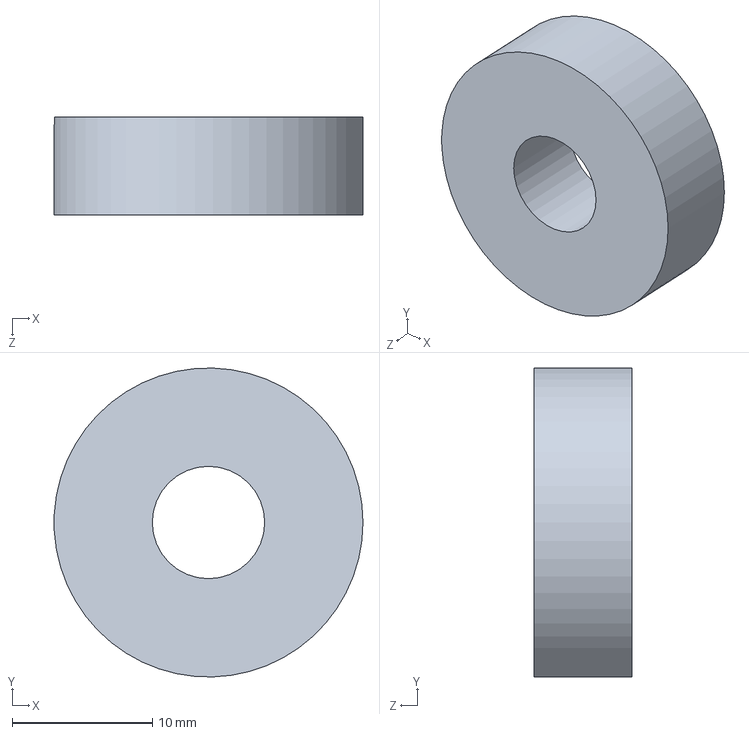
[picture p39: CAD file, 2026-10-13]
cad/solidworks/model/parts/BearingEnvelope_22x8x7.SLDPRT
22.0 x 22.0 x 7.00 mm
