A123536/final-report/cad/solidworks/model/parts/TorsionSpringEnvelope_OD38_ID12_W6p4.SLDPRT

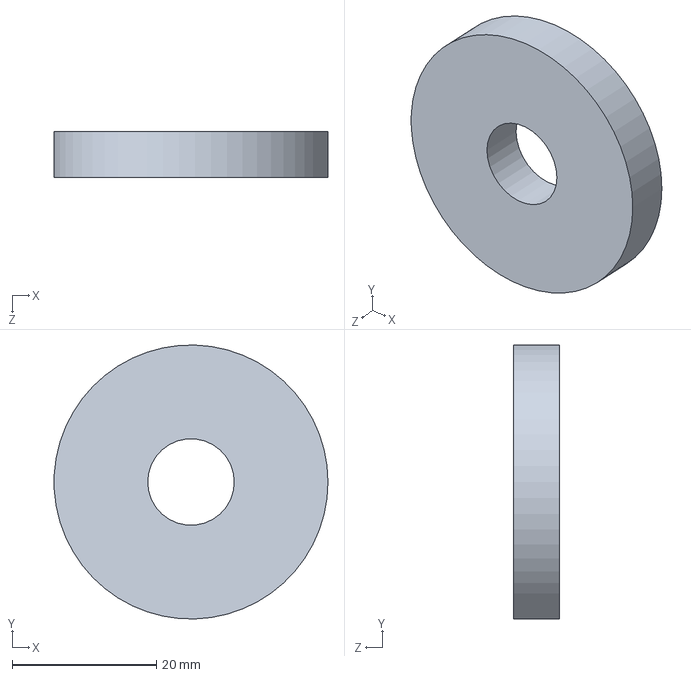
[picture p40: CAD file, 2026-10-13]
cad/solidworks/model/parts/TorsionSpringEnvelope_OD38_ID12_W6p4.SLDPRT
38.0 x 38.0 x 6.40 mm
