A123536/final-report/cad/solidworks/model/parts/SIGNAL_HARNESS_D3p2_L114p4_0.SLDPRT

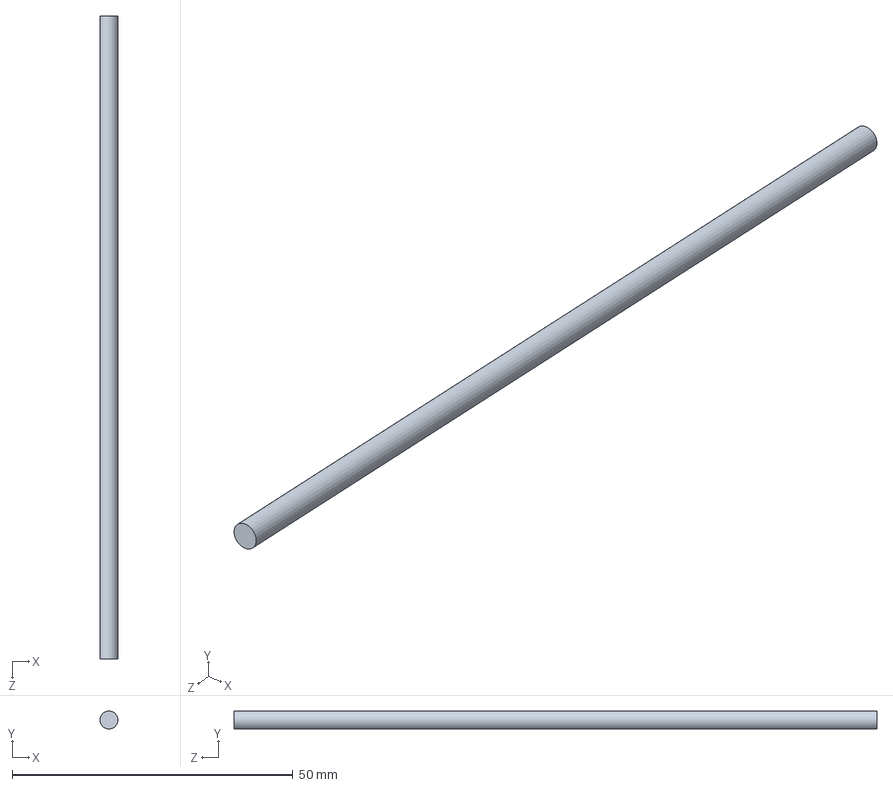
[picture p41: CAD file, 2026-10-13]
cad/solidworks/model/parts/SIGNAL_HARNESS_D3p2_L114p4_0.SLDPRT
3.20 x 3.18 x 114.4 mm
