A123536/final-report/(list of files, cad)

Other CAD files:
cad/solidworks/model/parts/SIGNAL_HARNESS_D3p2_L64p4_1.SLDPRT
cad/solidworks/model/parts/DrivenWheel_D60_W28.SLDPRT
cad/solidworks/model/V_Pipe_Robot_Concept_ID150.SLDASM
cad/solidworks/model/V_Pipe_Robot_Concept_ID150_GA.SLDDRW
cad/solidworks/model/parts/MC33926_50x30x12.SLDPRT
