A123536/final-report/design/printable_enclosure_joint_plan.md

# 可拆装 PETG 外壳拼接方案（Rev C）

> 历史修订：2026-11-03 已将用户指定的 2026-10-13 ZIP 设为当前模型；本六件外壳方案不属于当前基线。本文及其验证结论对应 [6ad9346 中的原模型和打印文件](https://github.com/A123536/final-report/tree/6ad93463daccba81145dd6c9fa55dd463d4a2adb/cad/solidworks/model/printable_enclosure)。

本轮将原模型中的电源罩、控制罩、摄像头实心预留包络改成六个独立、单实体的打印零件。用户确认采用 **FDM + PETG**。连杆、轮轴、齿轮、弹簧等原有独立零件保持各自的结构用途；本方案针对电子设备外壳，不把薄壁打印罩作为弹簧预紧机构的承力件。

## 分件与拼接

| 编号 | 零件 | 数量 | 拼接方式 |
|---|---|---:|---|
| E-01 | 电源舱上盖 | 1 | 四只 M3 热熔螺母；与 E-02 对合 |
| E-02 | 电源舱底板 | 1 | 六个短定位挡舌，四个 φ3.4 螺钉通孔 |
| E-03 | 控制舱上盖 | 1 | 四只 M3 热熔螺母；与 E-04 对合 |
| E-04 | 控制舱底板 | 1 | 六个短定位挡舌，四个 φ3.4 螺钉通孔 |
| E-05 | 摄像头主体 | 1 | 四只 M2.5 热熔螺母，前端敞口 |
| E-06 | 摄像头前盖 | 1 | 四个短定位挡舌、φ19.5 镜头孔、四个 φ3.0 通孔 |

采用“短挡舌定位 + 金属螺纹紧固”。挡舌控制横向错位；螺钉负责压紧接缝，维修时可单独拆开各舱。没有长距离滑轨，板卡和线束装好后可沿开口法向直接合盖。设备舱底板挡舌插入 2.0 mm，距内壁单边间隙 0.30 mm；摄像头前盖挡舌插入 2.0 mm，单边间隙 0.50 mm。电源舱正侧的一只螺柱移至 X=5 mm，避让保险端子，同时用非对称孔位区分底板安装方向。

设备舱盖沿原位置法向外移 3 mm，为底板和螺钉留出空间；保险端子另行内收、沿连杆调整，信号通道由 Y=37 改为 Y=36.5 mm。实际模型以本轮 SOLIDWORKS 生成源和验证记录为准，旧 GLB 渲染尚未同步这些细节。

## 关键尺寸（毫米）

| 项目 | 尺寸 |
|---|---|
| 两只上盖主体 / 内腔 | 72×62×22 / 68×58×20；壁、顶厚 2.0 |
| 上盖含侧螺柱总宽 | 69.0 |
| 底板主体厚 / 含挡舌高度 | 2.4 / 4.4 |
| 合盖后舱体高度 | 24.4（不含螺钉头） |
| M3 螺柱 / 暂定热熔底孔 | φ8×8 / φ4.2 贯通 |
| 电源舱螺孔中心（X,Y） | (-25,-30.5)、(25,-30.5)、(-25,30.5)、(5,30.5) |
| 控制舱螺孔中心（X,Y） | (±25,±30.5) 四种组合 |
| 设备舱过线槽 | 两端开口边各一处；12 宽、5.1 净高 |
| 相机主体 / 前盖 | 50×48×32，壁厚 2.0 / 48×32×2.4 |
| 相机螺孔中心（Y,Z） | (±19.5,±11.5) 四种组合；孔轴沿 X |
| 相机螺柱 / 暂定热熔底孔 | φ6×9 / φ4.0 |
| 相机过线口 | 后端两侧各一处；9 宽×12 高，后缘开槽 |
| 相机前盖螺孔 / 光学开口 | φ3.0 / φ19.5 |

设备舱坐标原点在上盖主体中心，底板中心相对上盖沿局部 Z=-12.2 mm；摄像头原点在主体中心，前盖中心在局部 X=26.2 mm。七页 A3 原生工程图含爆炸总图和 E-01 至 E-06 各自的视图、外形尺寸及孔位坐标表。分件 STEP 保留设计坐标，STL 已转换到建议的打印方向和毫米单位。

## 紧固件与装配

| 器件 | 数量 | 本轮约束 |
|---|---:|---|
| M3×10 内六角低圆头螺钉 | 8 | 头外径≤5.7、头高≤1.7；普通高圆柱头会碰编码器 |
| M3 热熔螺母 | 8 | 长 5–6；实际安装底孔按购入螺母和试打结果确认 |
| M2.5×8 内六角螺钉 | 4 | 头外径≤4.5、头高≤2.5 |
| M2.5 热熔螺母 | 4 | 建议长 4–5；实际安装底孔需校准 |
| 开口护线套或软护边 | 视线径 | 过线口防磨，安装后不得挤压线束 |

装配顺序：

1. 先试打孔径和挡舌配合，清理首层象脚、支撑及孔内毛刺。不要把整体 STL 等比例缩放来修正孔径。
2. 从盖口侧将热熔螺母垂直安装到螺柱，端面与接缝面齐平；完全冷却后检查螺纹可用性。
3. 用绝缘支撑固定板卡，再装线束及护线套。板卡真实孔位尚待实物测量，当前包络中的板卡孔不能当作已完成的安装孔。
4. 让定位挡舌进入内腔，确认未夹线，底板自然贴合；再交叉、逐步拧紧四只螺钉。不要用螺钉强拉错位零件就位。
5. 相机前盖同样先定位后紧固。镜头孔只对应当前 φ18 包络；最终镜头支架、镜头座和板卡固定孔需按实物补齐。
6. 舱体到机架的最终夹持座、散热及密封设计，结合实物板卡、轨道与温升实测确定。本轮已完成的是各舱自身可拆装拼接。

## 打印设置与方向

基线：0.4 mm 喷嘴、0.20 mm 层高、4–5 道外墙、6 层顶底、30–40% 填充。温度、冷却与速度使用所购 PETG 的供应商配置，再用试件校准。

| 零件 | 建议朝向 | 切片后应见尺寸 | 支撑 |
|---|---|---|---|
| E-01、E-03 | 顶部大平面贴平台、开口朝上 | 72×69×22 | 螺柱外挑肩部局部支撑，避免支撑堵孔 |
| E-02、E-04 | 底面贴平台、挡舌朝上 | 72×69×4.4 | 通常无需支撑 |
| E-05 | 后壁贴平台、前端开口朝上 | 32×48×50 | 两处过线桥需局部支撑或验证桥接 |
| E-06 | 前端外表面贴平台、挡舌朝上 | 32×48×4.4 | 通常无需支撑 |

最大单件平台占用 72×69 mm，可逐件打印。STL 中六件已逐个验证为单个封闭、法向一致的实体，Z 最低点为 0；导入切片软件时按毫米，不要选择英寸。完整打印前先看切片层预览，确认薄壁、螺柱与定位舌没有丢失。

本轮间隙和底孔是样机起点。Prusa 的官方设计指南强调不存在通用于所有机器、材料和方向的装配间隙；CNC Kitchen 的热熔螺母指南也要求按实际螺母和试件确定孔径。因此不把这组参数视为所有打印机都能免修配的固定公差。

参考：

- [Prusa：面向 3D 打印的建模与公差](https://help.prusa3d.com/article/modeling-with-3d-printing-in-mind_164135)
- [CNC Kitchen：热熔螺母安装和孔径试件](https://www.cnckitchen.com/blog/tips-and-tricks-for-heat-set-inserts)
- [Accu：M3 ISO 7380 头部尺寸示例](https://www.accu.co.uk/vented-socket-button-head-screws/416098-SSBV-M3-5-A2)

本轮 CAD 检查针对装配包络、实体、螺孔与螺钉占用空间；不代表已完成 PETG 螺柱拔出强度、抗振、热循环或实物管内试验。
