A123536/final-report/design/procurement_guide_20261028.md

# 完整采购建议（含电脑端视觉，2026-10-28）

> 历史采购修订：当前模型已于 2026-11-03 切换为用户指定的 2026-10-13 ZIP。本文、配套 JSON 和 Excel 保留为 10 月 28 日的独立采购参考，未按当前选定模型重新匹配；当前包配套清单见 [assembly_and_procurement.md](assembly_and_procurement.md)。

本轮按照用户确认的“电脑端实时看画面、拍照录像，并预留识别能力”选型。完整87项清单的数据源为 `procurement_20261028.json`，对应Excel含建议数量、已有数量、待买数量、采购状态、报价、关键规格、验收要求及厂家资料。

现阶段可先买51项电子器件、视觉和常用耗材；14项需先确认规格；13项需制造图后加工；9项是可选或已有工具可省略。这里的“现在买”表示可以进行样机采购/台架测试，不表示已核实国内现货，也不表示新器件已完成装机CAD校核。

## 主购组合

| 用途 | 推荐型号 | 装机数量 | 下单要点 |
|---|---|---:|---|
| 运动主控 | WeAct MiniF4 STM32F411CEU6 V3.1 | 1 | 建议买2块含备件；3.3V逻辑；保留现有F411控制路线 |
| 电机 | Hiwonder JGB37-520R90-12，AB编码器版 | 2 | 12V、90:1、空载110rpm；官方该版本堵转3.2A；必须附线序与尺寸图 |
| 双路驱动 | Pololu Dual MC33926 Carrier #1213 | 1 | 约3A连续/路、5A短时峰值、3–5V逻辑；不买同芯片大盾板 |
| SWD调试 | STLINK-V3MINIE | 1 | 另配STDC14转SWD排线；已有可用调试器则不重复买 |
| 机器人通信 | Waveshare RS485 Board (3.3V)，SP3485 | 1 | 建议买2块含备件；不是5V MAX485板 |
| 电脑通信 | Waveshare USB TO RS485/422隔离版 | 1 | 放管外，二线半双工模式 |
| 编码器缓冲 | SN74LVC245A模块 | 1 | 3.3V供电、输入容忍5.5V；接法须按编码器输出类型确认 |
| 地面电源 | MEAN WELL GST120A24-P1M | 1 | 24V/5A/120W；配国标至IEC C13成品电源线和匹配DC线 |
| 电机电源降压 | Pololu D42V110F12 #5677 | 1 | 12V、典型9A；43.2×31.8×9mm；实际输入/散热下验收，不直接把9A当封壳保证值 |
| 控制/视觉5V | Pololu D24V50F5 #2851 | 1 | 5V、典型5A；20.3×17.8×8.8mm；项目先以连续3A为验收目标 |
| 图传主板 | Luckfox Pico Max（RV1106G3/256MB） | 1 | 有线100M以太网；配官方支持的系统和图传流程 |
| 相机 | Waveshare SC3336 3MP Camera (B) | 1 | Luckfox配套；手调焦、3.95mm/F2.0、98.3°对角视场；含匹配FFC |
| 录像/备份卡 | SanDisk High Endurance 32GB microSD或同级 | 1 | 本地缓存/备份；板载NAND可启动，录像功能仍需配置 |
| 图传拖线 | LAPP ETHERLINE FD P CAT.5e 2170289或等效 | 15m，建议买18m | 两对100M拖链网线；约5.9mm、48g/m；接头须适配多股细线 |
| 电源拖线 | 高柔纯铜2×0.75mm² | 15m，建议买18m | 厂家确认连续弯曲、电流能力；验收整段压降 |
| RS485拖线 | 120Ω高柔屏蔽2对×0.22mm² | 15m，建议买18m | 一对A/B，另有参考地；不把网线空闲芯随意混接电源 |
| 主轴轴承 | SKF 619/8-2RS1或同尺寸698-2RS | 6，建议买8 | 必须8×19×6mm；不是608的8×22×7mm |
| 惰轮轴承 | 686-2RS | 2，建议买4 | 6×13×5mm；备量也覆盖后续改双支撑的可能 |
| 打印材料 | eSUN PETG 1.75mm或同级PETG | 1kg | 六件外壳均用PETG；含试件及失败打印余量 |
| 设备舱盖螺钉 | ISO7380-1 M3×10低圆头 | 8，建议买20 | 头径≤5.7mm，头高≤1.7mm；普通高圆柱头会碰编码器 |
| 热熔嵌件 | M3长5mm、M2.5长4–5mm | 8+4，建议各20 | 底孔暂定φ4.2/φ4.0mm，按实际嵌件试打校准 |
| 相机盖螺钉 | M2.5×8内六角圆柱头 | 4，建议买20 | 头径≤4.5mm、头高≤2.5mm；相机壳修改后复核 |

上述型号的技术依据来自厂家资料，不是国内店铺现货承诺。Excel保留空白单价列，填入含税实际报价后自动汇总已填部分；没有报价的项目不当作零成本。

## 视觉、供电和控制如何连接

```text
SC3336(B) --短CSI排线--> Luckfox Pico Max --15m有线以太网--> 电脑
                                                            看图/录像
                                                            后续OpenCV/识别

STM32F411 --SP3485--> 独立RS485拖线 --> 管外隔离USB-RS485 --> 电脑控制

管外24V/5A --> 保险/急停 --> 15m电源线 --> 机器人24→12V
                                               ├─MC33926→两台电机
                                               └─12→5V→主控、编码器、视觉
```

不需要另买一套OpenMV、MaixCAM或树莓派。电脑端识别可读取同一视频流，不必立即增加板端AI任务。SC3336手动调焦应先在实际管径、照明和目标工作距离上试验。以1080p、25/30fps作为起始配置目标，实际帧率、延迟、丢帧和缺陷分辨率需测试。

白光补光采用低功率恒压环形板起步，独立供电，配3.3V可控MOS开关；先验证近焦和反光，再决定镜头升级。SC3336(B)的固定孔不提供补光电源。

## 不能照旧直接下单的几项

### 1. 全向轮

必须买普通90°全向轮，不是45°麦克纳姆轮。现机构中心轮的最大法向力约53.24N，取1.5余量后需要约80N单轮允许径向载荷，约8kgf。轮体外径60mm、宽≤28mm、φ8轮毂兼容、高摩擦PU/橡胶滚子须同时满足。

本轮没有核实到可以直接宣称全部满足的现货型号。可向航发/NEXUS等专业厂家按要求询价或定制，拿到图纸和载荷条件后再决定。已核查的Nexus14145虽为60mm，但厂家仅列3kg承载，不能直接用于当前预紧力。不要因整机只有1.6kg就忽略压壁弹簧带来的轮载。

### 2. 扭簧、齿轮和支架

- 扭簧：左右旋各1根，每根等效刚度0.0145N·m/deg，工作约99–118°，验证转矩不低于2.6N·m。OD38/ID12/W6.4仍只是包络，不能当作已完成弹簧设计。
- 齿轮：m1、20°直齿；电机25T×2、惰轮25T×2、轮轴40T×2；有效齿宽7mm。市售带长轮毂或10mm齿宽的件不能直接装入现概念包络。
- 轮轴：概念φ8×74两根、φ8×92一根；惰轮轴φ6×14两根。轴肩、槽位、公差和最终长度待制造图，不能凭这几个数直接下车加工单。
- 导轨、轴承座、电机座、关节簧腿座、限位座和齿轮护罩必须在实物测量后出制造图。原CAD中122×7×16mm轨道不是3mm铝板侧板，也没有完整孔位。

### 3. 新电机参数与保护

沿用同一家原店的JGB37-520-12100-EN时，以该店实物规格为准；找不到原版本时，本表给出Hiwonder R90-12作为可核查的采购选型。Hiwonder该型号官方额定转矩2.6kg·cm、堵转3.2A，与旧模型2.4A等假设不同，不能混用电流—转矩曲线、安装孔和轴伸。MC33926单路约3A连续、5A短峰值，需要电流保护、堵转切断及封壳温升验收。

### 4. 相机壳和拖线入口

旧的50×48×32mm相机舱与φ18镜头包络不能直接视为所选视觉套件已经适配。主板、RJ45接头、线缆弯曲空间、灯环和保护窗都要计入。先买视觉套件做台架，E-05/E-06按实物重新设计后再正式打印。本轮仅更新采购建议，没有修改CAD或重跑新增载荷的整机仿真。

新增图传线后，原单根φ7拖线/单M12入口也需更新。分别选择合适的M12/M16或多孔护线结构，并让回收绳与金属机架承担拖拽载荷。

LAPP所选两对线约48g/m，原仿真完整线束的保守上限为120g/m，因此电源、RS485、回收绳与护套合计约有72g/m余量。装好后称1m完整线束；超过上限则重算牵引，不能继续引用旧的1.36安全系数。也要重新称整机是否超过1.8kg。

## 最省返工的下单顺序

1. 首批购买电机及配套线、主控/驱动/调试/485、电源两级降压、Luckfox/SC3336套件、短网线、保护件和测量工具，先调通电机和有线视频。
2. 同时把全向轮与扭簧要求发给厂家询价；要求真实尺寸图、允许载荷条件、编码器电平、弹簧角度—转矩曲线。此处是用户自行询价模板，本轮未替用户联系商家。
3. 确认轮子/电机/板卡实物后，补制造级机械图与新相机壳，再下加工单。不要把旧的六件外壳“可拼接”误认为整机安装座都已完成。
4. 买15m正式拖线前可先拿1m同规格样线；核对整束质量、线径和接头，再买足18m含余量。
5. 工具、电脑网口、学校试验管和调试器如果已经有，在Excel“已备数量”中登记，自动扣减，不重复购买。

## 给轮子/弹簧厂家的询价文字

**全向轮**：需要3只普通90°全向轮，用于管内预紧行走，外径60mm，轮体宽不大于28mm，φ8轮毂兼容，PU或高摩擦橡胶滚子。单轮允许径向载荷至少80N（约8kgf），请提供载荷的静态/动态条件、实际尺寸图、轮毂连接孔型及滚子材料。不要提供45°麦克纳姆轮替代。

**扭簧**：需要镜像左/右旋各1根，等效工作刚度每根0.0145N·m/deg，工作角约99–118°，单根工作转矩约1.72N·m，要求验证转矩不低于2.6N·m且不产生永久变形。安装包络和簧腿方向后续按轮毂/轴承实物图确认，请协助校核线径、圈数、工作预紧、应力和疲劳寿命，并提供角度—转矩曲线。不得仅按OD38/ID12/W6.4直接照抄绕制。

## 主要厂家资料

- [Hiwonder JGB37-520规格](https://www.hiwonder.com/products/hall-encoder-dc-geared-motor)
- [Pololu MC33926 Carrier #1213](https://www.pololu.com/product/1213)
- [WeAct MiniF4官方仓库](https://github.com/WeActStudio/WeActStudio.MiniSTM32F4x1)
- [Luckfox Pico Pro/Max](https://wiki.luckfox.com/Luckfox-Pico-Pro-Max) 与 [官方CSI流程](https://wiki.luckfox.com/Luckfox-Pico-Pro-Max/CSI-Camera)
- [Waveshare SC3336相机B](https://www.waveshare.com/wiki/SC3336_3MP_Camera_(B))
- [MEAN WELL GST120A规格](https://www.meanwell.com/Upload/PDF/GST120A/GST120A-SPEC.PDF)
- [Pololu D42V110F12](https://pololu.com/product/5677) 与 [D24V50F5](https://www.pololu.com/product/2851)
- [Nexus14145承载规格](https://www.nexusrobot.com/product/60mm-aluminum-double-omni-wheel-basic-14145.html)
- [SKF轴承目录](https://www.skf.com/binaries/pub12/Images/0901d196802809de-Rolling-bearings---17000_1-EN_tcm_12-121486.pdf)

本清单中的通用标准件、耗材及定制验收指标是项目采购要求；未为每一项虚构“厂家专属型号”，没有核实的安装条件保持待确认。
