A123536/final-report/design/assembly_and_procurement.md

# V 型管道机器人装配与采购清单

## 1 当前三维方案中的器材位置

### 后侧动力模块

- 后主动轮及独立 φ8 mm 轮轴。
- JGB37-520 电机，电机置于轮轴内侧并通过 25/40 齿轮驱动轮轴。
- 24 V 转 12 V 降压模块。
- 12 V 电机支路保险丝和电源端子。
- 尾部 M12 电缆格兰头及拖线应力释放夹。

后连杆为动力舱，预留内部空间 `92 × 64 × 30 mm`。

### 中心被动模块

- φ60 mm 被动全向轮。
- φ8 mm 中心轴及两只轴承。
- 左右各一根镜像扭簧。
- 90°和125°机械限位。
- 装管时使用的可拔锁销。
- 电源线与信号线分别从中心轴下方两侧跨越，保留不少于30 mm柔性弯曲段。

### 前侧控制模块

- 前主动轮、独立 φ8 mm 轮轴和第二台JGB37-520电机。
- 双路MC33926电机驱动板。
- STM32F411控制板。
- 3.3 V RS-485模块。
- 两台电机编码器接口。
- 12 V转5 V辅助电源模块。

前连杆为控制舱，预留内部空间 `92 × 64 × 30 mm`。电机驱动器与控制板采用独立插槽，周围至少保留5 mm散热空间。

### 前端扩展模块

- 预留摄像头舱：`50 × 48 × 32 mm`。
- 正面预留约φ18 mm镜头孔。
- 预留4个M3安装点。
- 预留5 V、GND、UART TX、UART RX以及一组备用I²C线。

当前阶段不需要购买摄像头。

## 2 接线规划

电源线和编码器/通信线采用分离线槽：

```text
地面24 V电源
  -> 15 m拖线
  -> M12格兰头
  -> 24 V保险
  -> 24 V转12 V降压
  -> MC33926
  -> 两台12 V电机

12 V
  -> 12 V转5 V降压
  -> STM32、编码器、RS-485
  -> 未来OpenMV摄像头接口

两台编码器A/B相
  -> STM32定时器编码器接口

STM32 UART
  -> MAX3485
  -> 拖线RS-485双绞线
  -> 地面USB转RS-485模块
```

布线要求：

- 电机线与编码器线尽量分开，平行距离不小于15 mm。
- 必须交叉时采用接近90°交叉。
- 电机端各并联一个 `0.1 µF` 陶瓷电容抑制电刷噪声。
- 每个舱体两端设置扎带桥或压线片，中心铰链处不得拉紧线束。
- 拖线外皮通过格兰头受力，焊点和端子不得承担拖拽载荷。
- 单独配置芳纶回收绳，不能使用电缆导体承担回收拉力。

## 3 建议立即购买的器件

### 动力和传动

| 器件 | 数量 | 关键规格 | 备注 |
|---|---:|---|---|
| JGB37-520-12100-EN编码减速电机 | 2 | 12 V、90:1、110 rpm、AB相编码器 | 已确认型号 |
| φ60全向轮 | 3 | 聚氨酯滚子、宽度不超过28 mm | 优先选可更换轮毂款 |
| φ8 mm夹紧式轮毂 | 3 | 与全向轮孔型匹配 | 禁止仅用顶丝承受全部转矩 |
| 模数1、25齿圆柱齿轮 | 2 | φ6 mm D形孔或可加工孔 | 电机轴齿轮 |
| 模数1、40齿圆柱齿轮 | 2 | φ8 mm孔 | 轮轴齿轮 |
| φ8 mm精密钢轴 | 3 | 两根约90 mm，一根约100 mm | 最终按轮宽切割 |
| 619/8-2RS深沟球轴承 | 6 | 8×19×6 mm | 每根轮轴两只 |
| 双路MC33926驱动板 | 1 | 5–28 V，每路约3 A连续、5 A峰值 | 带电流反馈和保护 |

MC33926官方性能说明：[Pololu Dual MC33926](https://www.pololu.com/product/1213)。如果无法购买，可用Cytron MDD3A替代，但需另外增加电流检测。

### 控制和通信

| 器件 | 数量 | 关键规格 | 备注 |
|---|---:|---|---|
| WeAct STM32F411CEU6 MiniF4控制板 | 1 | 100 MHz、3.3 V逻辑 | 读取两路AB编码器并输出双路PWM |
| MAX3485 RS-485模块 | 2 | 3.3 V逻辑 | 机器人端和地面端各一只 |
| USB转RS-485模块 | 1 | 支持Windows | 地面电脑调试，可与第二只MAX3485二选一 |
| 6芯JST-PH插头线 | 2套 | 与电机编码器接口匹配 | 电机和编码器连接 |
| 2芯锁紧电源连接器 | 4套 | 额定电流不低于5 A | 电机与电源支路 |
| 0.1 µF陶瓷电容 | 4 | 50 V或以上 | 每台电机端子及电源旁路 |
| 470–1000 µF电解电容 | 2 | 25 V或以上 | 驱动器12 V输入附近 |

控制板资料：[WeAct STM32F411CEU6](https://github.com/weactstudio/weactstudio.ministm32f4x1)。

### 供电和拖线

| 器件 | 数量 | 关键规格 | 备注 |
|---|---:|---|---|
| 24 V直流电源 | 1 | 4 A或更高 | 放置在管道外部 |
| 24 V转12 V降压模块 | 1 | 持续6 A、带过流/过温保护 | 安装在后动力舱 |
| 12 V转5 V降压模块 | 1 | 持续3 A | 控制板、编码器和未来摄像头 |
| 24 V支路保险丝座 | 1 | 配3 A慢断保险丝 | 地面电源端 |
| 12 V电机保险丝座 | 1 | 配5 A保险丝 | 机器人端 |
| 复合拖链电缆 | 15 m | 2×0.75 mm²电源＋1对0.22 mm²屏蔽双绞线 | 外径尽量≤7.5 mm |
| 芳纶回收绳 | 15 m | 直径1.5–2 mm、拉力≥50 kg | 与拖线每0.5 m固定一次 |
| M12防水电缆格兰头 | 2 | 适配实际电缆外径 | 机器人端及地面控制盒 |
| 编织网管和热缩管 | 各1套 | 阻燃 | 线束保护 |

如果暂时只能得到普通线缆，可分别购买2芯0.75 mm²电源线和1对屏蔽RS-485线，再与回收绳一起穿入轻质编织套管。

### 机械结构和紧固件

| 器件 | 数量 | 关键规格 | 备注 |
|---|---:|---|---|
| 6061-T6铝板 | 1张 | 3 mm厚，约500×300 mm | 连杆侧板、轴承座和电机板 |
| PETG或PA-CF打印材料 | 1 kg | 不建议用普通脆性光敏树脂 | 外壳、盖板、线槽和相机舱 |
| M3内六角螺钉套装 | 1套 | M3×6/8/10/12/16/20 | 电机、轴承座、盖板 |
| M3尼龙锁紧螺母 | 30 | — | 防振松动 |
| M4内六角螺钉及锁紧螺母 | 各12 | — | 主要连杆连接 |
| φ4 mm快拔锁销 | 1 | 有效长度约40–50 mm | 装管时锁定125°夹角 |
| φ8 mm轴用挡圈 | 6 | 对应轴槽 | 轮轴定位 |
| 0.2/0.5/1 mm调整垫片 | 各10 | φ8 mm | 齿轮和轮轴轴向调整 |
| 中强度螺纹锁固胶 | 1 | 可拆型 | 金属紧固件防松 |
| PTFE薄片或低摩擦滑块 | 2–4 | 约20×10×2 mm | 可选防翻限位，不持续承载 |

## 4 需要定制、暂时不要直接购买的器件

### 中心扭簧

需要一对左旋/右旋镜像扭簧，目标等效参数为：

- 单根刚度：`0.0145 N·m/deg ±10%`；
- 工作转角：约99°–118°，另留装配余量；
- 单根最大工作转矩：约1.71 N·m；
- 按1.5安全系数，单根无永久变形转矩不低于2.6 N·m；
- 安装在φ8中心轴外的弹簧套筒上；
- 左右旋各一根，弹簧腿方向镜像。

该刚度较高，不建议盲购普通小扭簧。应先确定中心轮实际宽度、轴承座和弹簧套筒直径，再把安装空间、工作角和转矩要求交给弹簧厂家设计。采购前应索要角度－转矩曲线。

### 加工件

- 左右连杆侧板；
- 三套轴承座；
- 两套电机安装板；
- 中心弹簧套筒和限位块；
- D形孔25齿电机齿轮；
- φ8轮轴及挡圈槽；
- 125°装管锁销孔；
- 可拆电子舱盖板。

这些零件需要在下一阶段生成制造尺寸后再加工。

## 5 后续摄像头扩展件 暂不购买

当前模型预留的 `50 × 48 × 32 mm` 舱位可容纳OpenMV级别的小型视觉板。后续确定需求后再采购：

- OpenMV Cam H7/H7 Plus或其他摄像板；
- 广角镜头；
- 环形白光LED；
- 透明防护窗和密封圈；
- 5 V电源和UART线束。

OpenMV资料：[OpenMV Cam H7 Plus](https://docs.openmv.io/dev/openmvcam/quickref/openmv-cam-h7-plus.html)。

## 6 推荐采购顺序

1. 先购买全向轮、电机、齿轮、轴承和φ8轴，测量真实外形尺寸。
2. 同时购买MC33926、控制板、RS-485和两级降压模块，验证电机闭环控制。
3. 根据实测尺寸完成制造级三维零件和干涉检查。
4. 再定制扭簧和加工铝板件。
5. 最后购买拖线、格兰头、连接器及紧固件并完成总装。

不要在全向轮宽度、轮毂结构和弹簧空间尚未实测前批量加工结构件。
