A123536/final-report/cad/solidworks/model/SOLIDWORKS_ASSEMBLY_AUDIT.txt

Assembly: C:\Users\Lenovo\Documents\ChatGPT\final_project\cad\solidworks\model\V_Pipe_Robot_Concept_ID150.SLDASM
Configuration: ID150_NOMINAL
Display states: ROBOT_ONLY, WITH_PIPE
Top-level component count: 118
Hidden before finalization: 1
Default saved state: pipe hidden; robot visible
Pipe display override: transparency 0.88

BearingEnvelope_22x8x7-1
BearingEnvelope_22x8x7-2
BearingEnvelope_22x8x7-3
BearingEnvelope_22x8x7-4
BearingEnvelope_22x8x7-5
BearingEnvelope_22x8x7-6
Buck24to12_65x42x17-1
CableTieBridge_10x76x5-1
CableTieBridge_10x76x5-2
CableTieBridge_10x76x5-3
CableTieBridge_10x76x5-4
CameraLensEnvelope_D18_L7-1
CenterAxle_D10_L92-1
CenterStopTab_12x9x18-1
CenterStopTab_12x9x18-2
DrivenWheel_D60_W28-1
DrivenWheel_D60_W28-2
EncoderEnvelope_D33p8_L13p8-1
EncoderEnvelope_D33p8_L13p8-2
EquipmentBay_92x64x30-1
EquipmentBay_92x64x30-2
ExternalTether_D7_L30-1
FuseTerminal_24x16x12-1
FutureCameraBay_50x48x32-1
Gear25T_m1_Envelope_D27_ID6_W7-1
Gear25T_m1_Envelope_D27_ID6_W7-2
Gear40T_m1_Envelope_D42_ID8_W7-1
Gear40T_m1_Envelope_D42_ID8_W7-2
GearboxEnvelope_D37_L24-1
GearboxEnvelope_D37_L24-2
InsertionLockPin_D4_L84-1
LinkRail_122x7x16-1
LinkRail_122x7x16-2
LinkRail_122x7x16-3
LinkRail_122x7x16-4
M12GlandEnvelope_D14_L15-1
M3Boss_D3p2_L21-1
M3Boss_D3p2_L21-10
M3Boss_D3p2_L21-11
M3Boss_D3p2_L21-12
M3Boss_D3p2_L21-13
M3Boss_D3p2_L21-14
M3Boss_D3p2_L21-15
M3Boss_D3p2_L21-16
M3Boss_D3p2_L21-17
M3Boss_D3p2_L21-18
M3Boss_D3p2_L21-19
M3Boss_D3p2_L21-2
M3Boss_D3p2_L21-20
M3Boss_D3p2_L21-3
M3Boss_D3p2_L21-4
M3Boss_D3p2_L21-5
M3Boss_D3p2_L21-6
M3Boss_D3p2_L21-7
M3Boss_D3p2_L21-8
M3Boss_D3p2_L21-9
M3CameraMount_D3p2_L7-1
M3CameraMount_D3p2_L7-2
M3CameraMount_D3p2_L7-3
M3CameraMount_D3p2_L7-4
MC33926_50x30x12-1
MotorEnvelope_D32p7_L21p7-1
MotorEnvelope_D32p7_L21p7-2
OmniRoller_D6_L8-1
OmniRoller_D6_L8-10
OmniRoller_D6_L8-11
OmniRoller_D6_L8-12
OmniRoller_D6_L8-13
OmniRoller_D6_L8-14
OmniRoller_D6_L8-15
OmniRoller_D6_L8-16
OmniRoller_D6_L8-17
OmniRoller_D6_L8-18
OmniRoller_D6_L8-19
OmniRoller_D6_L8-2
OmniRoller_D6_L8-20
OmniRoller_D6_L8-21
OmniRoller_D6_L8-22
OmniRoller_D6_L8-23
OmniRoller_D6_L8-24
OmniRoller_D6_L8-25
OmniRoller_D6_L8-26
OmniRoller_D6_L8-27
OmniRoller_D6_L8-28
OmniRoller_D6_L8-29
OmniRoller_D6_L8-3
OmniRoller_D6_L8-30
OmniRoller_D6_L8-31
OmniRoller_D6_L8-32
OmniRoller_D6_L8-33
OmniRoller_D6_L8-34
OmniRoller_D6_L8-35
OmniRoller_D6_L8-36
OmniRoller_D6_L8-4
OmniRoller_D6_L8-5
OmniRoller_D6_L8-6
OmniRoller_D6_L8-7
OmniRoller_D6_L8-8
OmniRoller_D6_L8-9
PassiveWheel_D60_W28-1
Pipe_ID150_OD154_L430-1
POWER_HARNESS_D4p4_L115p6_0-1
POWER_HARNESS_D4p4_L60p4_2-1
POWER_HARNESS_D4p4_L61p0_1-1
POWER_HARNESS_D4p4_L93p3_3-1
RS485_25x18x9-1
SIGNAL_HARNESS_D3p2_L114p4_0-1
SIGNAL_HARNESS_D3p2_L64p1_2-1
SIGNAL_HARNESS_D3p2_L64p4_1-1
SIGNAL_HARNESS_D3p2_L93p3_3-1
STM32F411_53x22x10-1
TorsionSpringEnvelope_OD38_ID12_W6p4-1
TorsionSpringEnvelope_OD38_ID12_W6p4-2
WheelHub_D18_L36-1
WheelHub_D18_L36-2
WheelHub_D18_L36-3
WheelShaft_D8_L74-1
WheelShaft_D8_L74-2
