A123536/final-report/cad/outputs/assembly_isometric.png

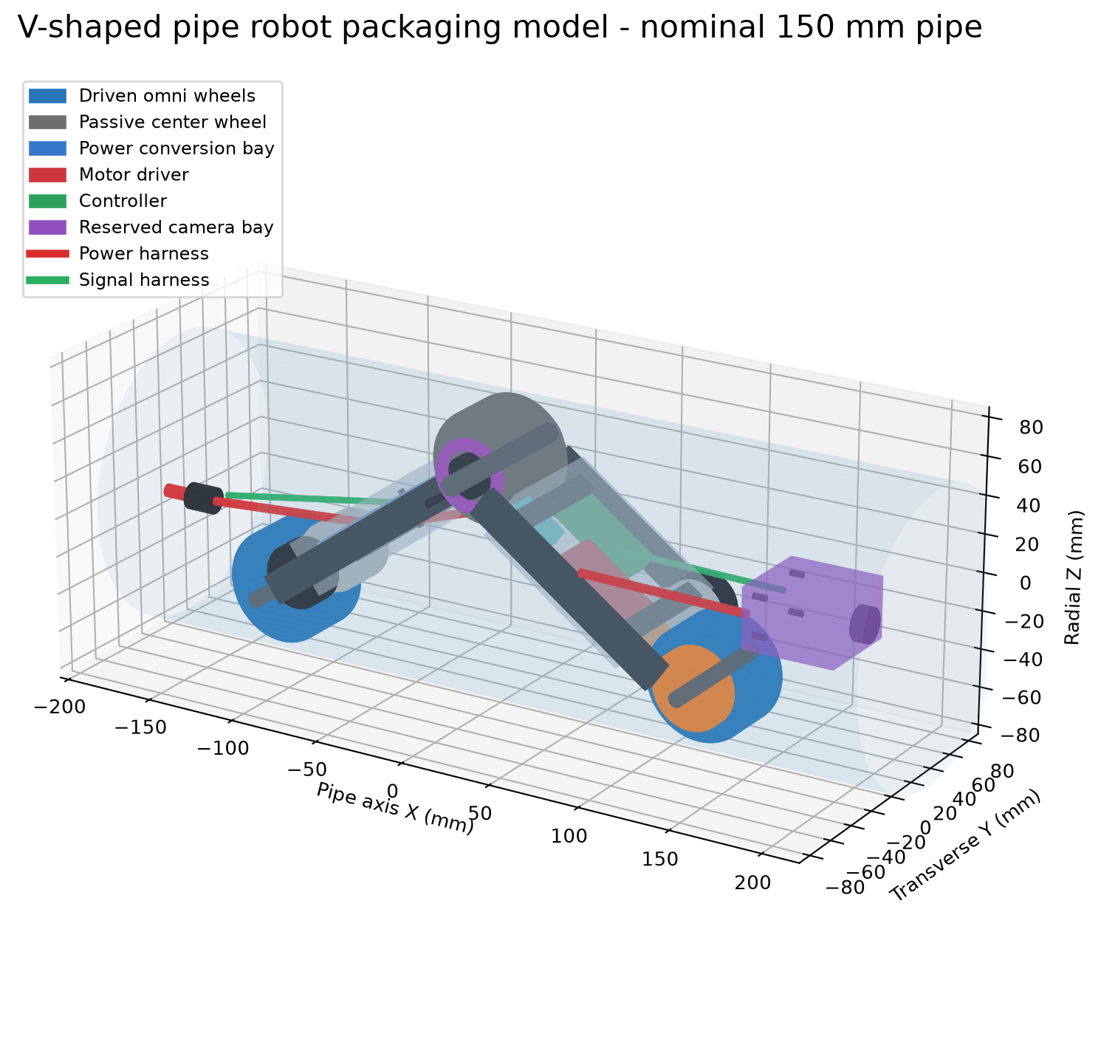
cad/outputs/assembly_isometric.png
