A123536/final-report/cad/outputs/assembly_opposite.png

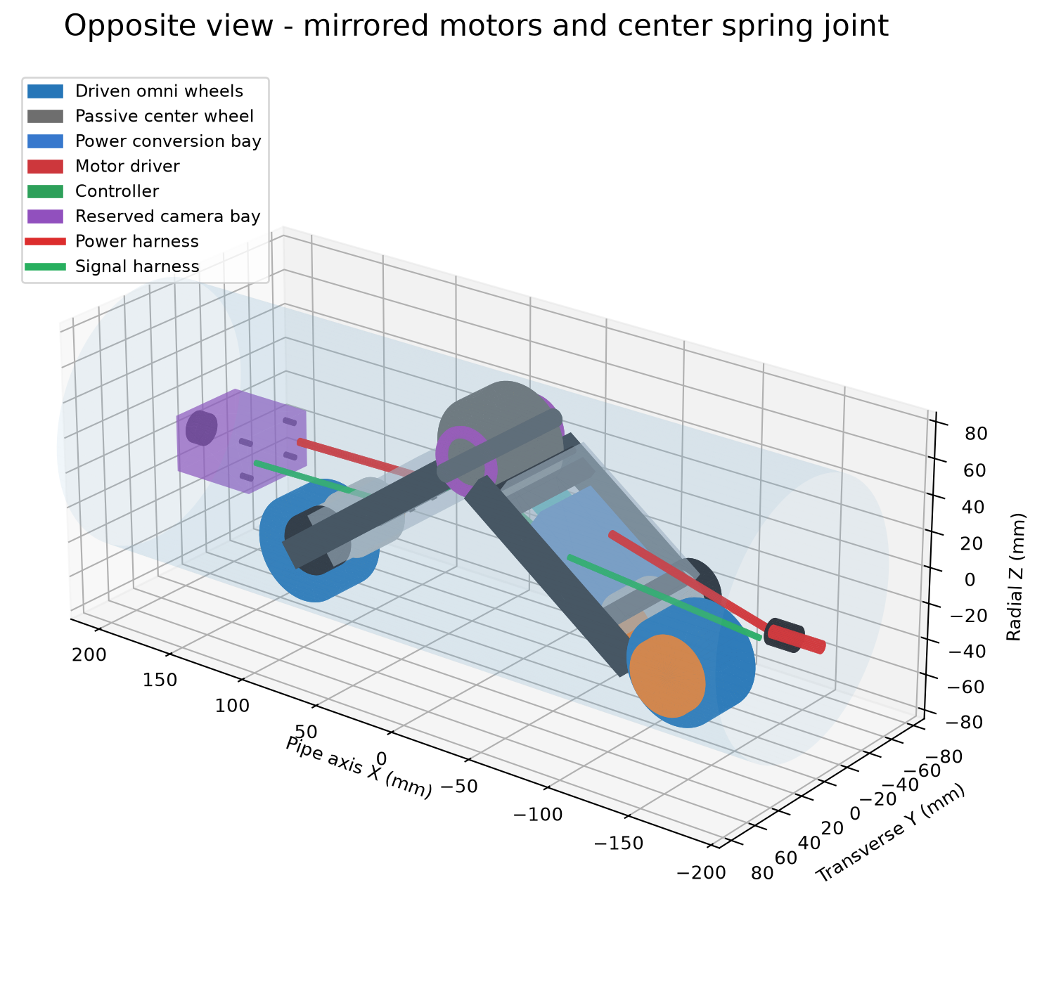
cad/outputs/assembly_opposite.png
