A123536/final-report/cad/outputs/equipment_and_wiring.png

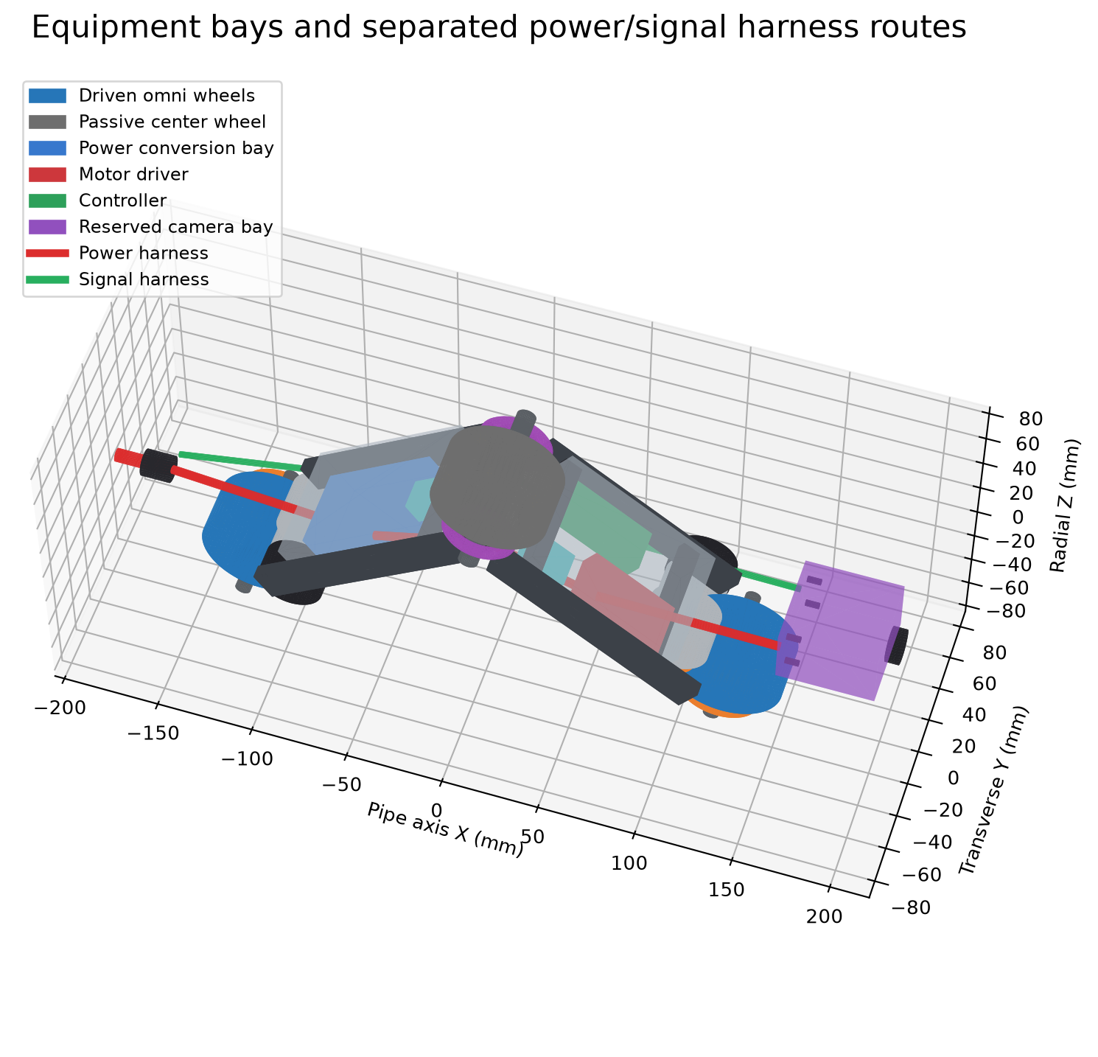
cad/outputs/equipment_and_wiring.png
