A123536/final-report/simulation/results/diameter_sweep.csv

pipe_diameter_mm | included_angle_deg | wheelbase_mm | overall_length_mm | spring_moment_Nm | center_normal_N | traction_mu_0_15_N | traction_mu_0_2_N | traction_mu_0_3_N | traction_mu_0_4_N | traction_mu_0_5_N
140.0 | 118.07510414236292 | 257.2514028844388 | 317.25140288443873 | 3.4241780201285246 | 53.24251656915889 | 10.340777485373833 | 13.787703313831779 | 20.681554970747666 | 27.575406627663558 | 28.243152000000002
140.125 | 117.96141459326506 | 257.0981483627492 | 317.0981483627492 | 3.420881023204687 | 53.22295854699102 | 10.337843782048653 | 13.783791709398205 | 20.675687564097306 | 27.56758341879641 | 28.243152000000002
140.25 | 117.84766139968399 | 256.9445547686658 | 316.9445547686658 | 3.417582180590836 | 53.203418670113926 | 10.33491280051709 | 13.779883734022787 | 20.66982560103418 | 27.559767468045575 | 28.243152000000002
140.375 | 117.73384432346901 | 256.7906215060701 | 316.7906215060701 | 3.4142814853806014 | 53.18389690956674 | 10.33198453643501 | 13.775979381913348 | 20.66396907287002 | 27.551958763826697 | 28.243152000000002
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
