A123536/final-report/simulation/results/geometry_and_preload.png

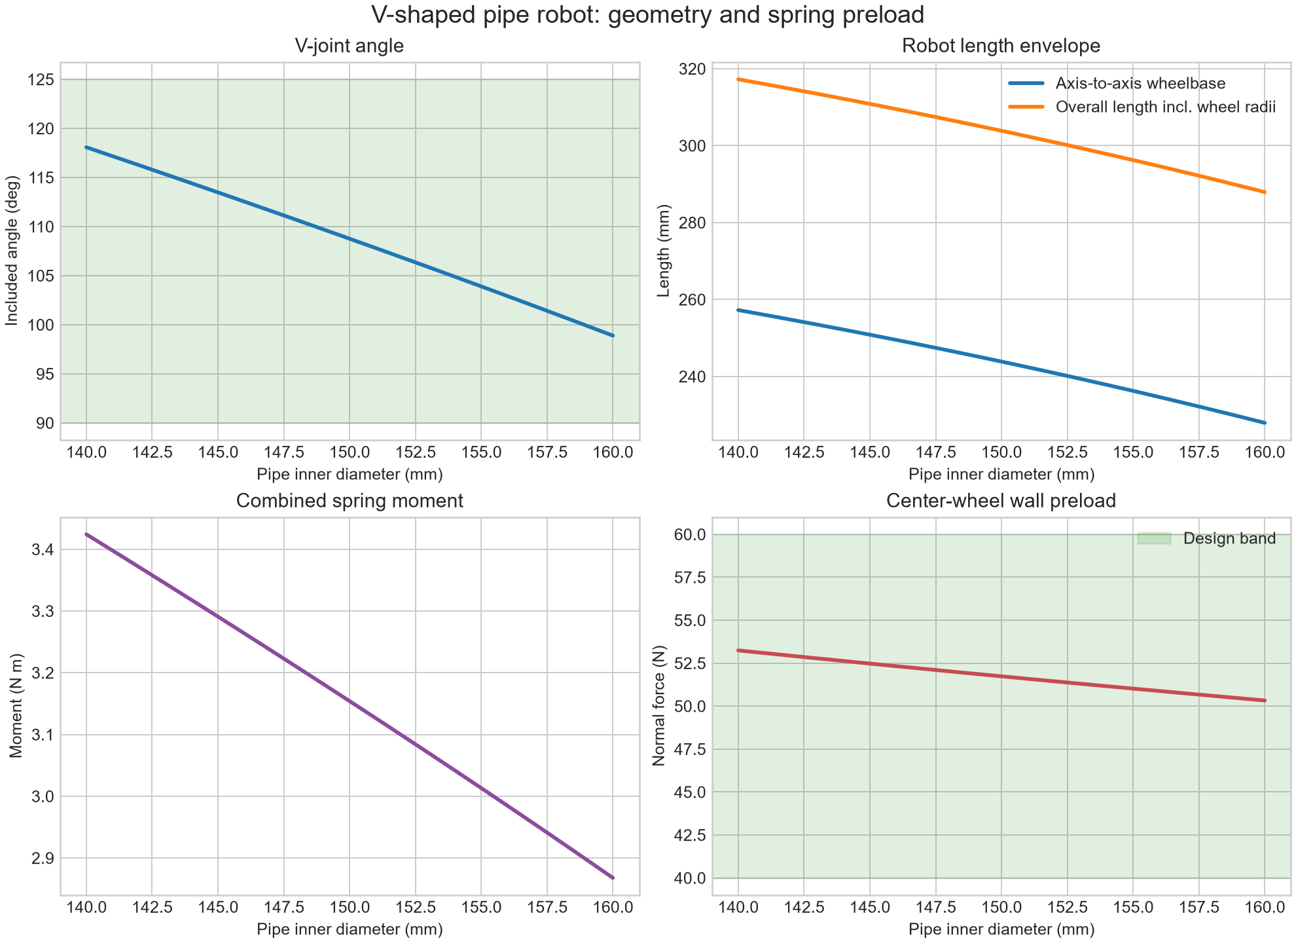
simulation/results/geometry_and_preload.png
