A123536/final-report/simulation/results/geometry_snapshots.png

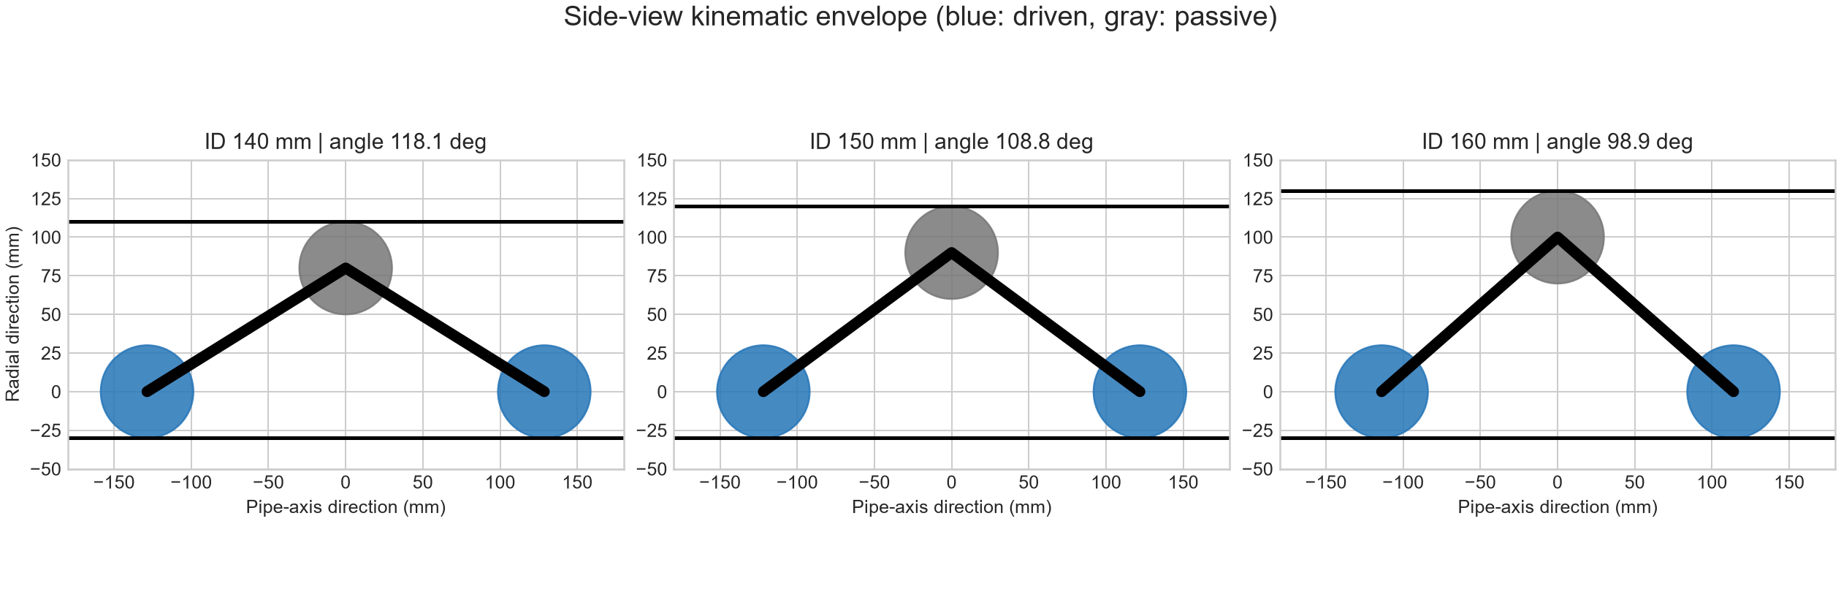
simulation/results/geometry_snapshots.png
