A123536/final-report/simulation/results/monte_carlo_robustness.png

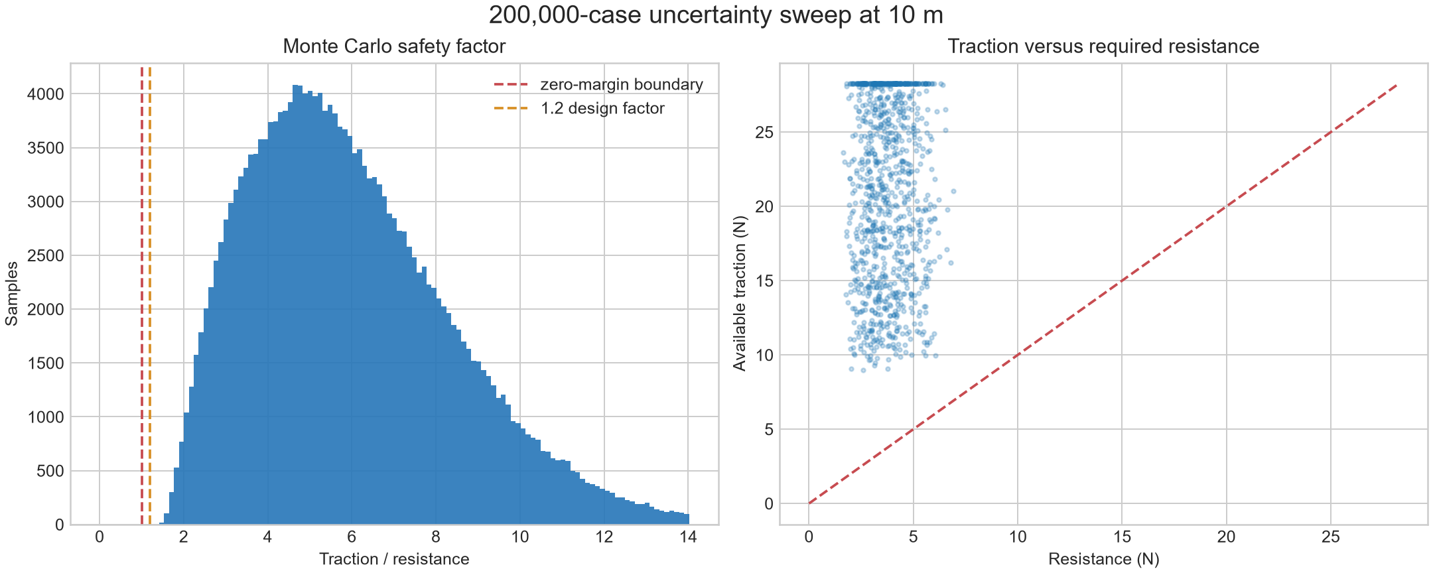
simulation/results/monte_carlo_robustness.png
