A123536/final-report/simulation/results/traction_and_tether.png

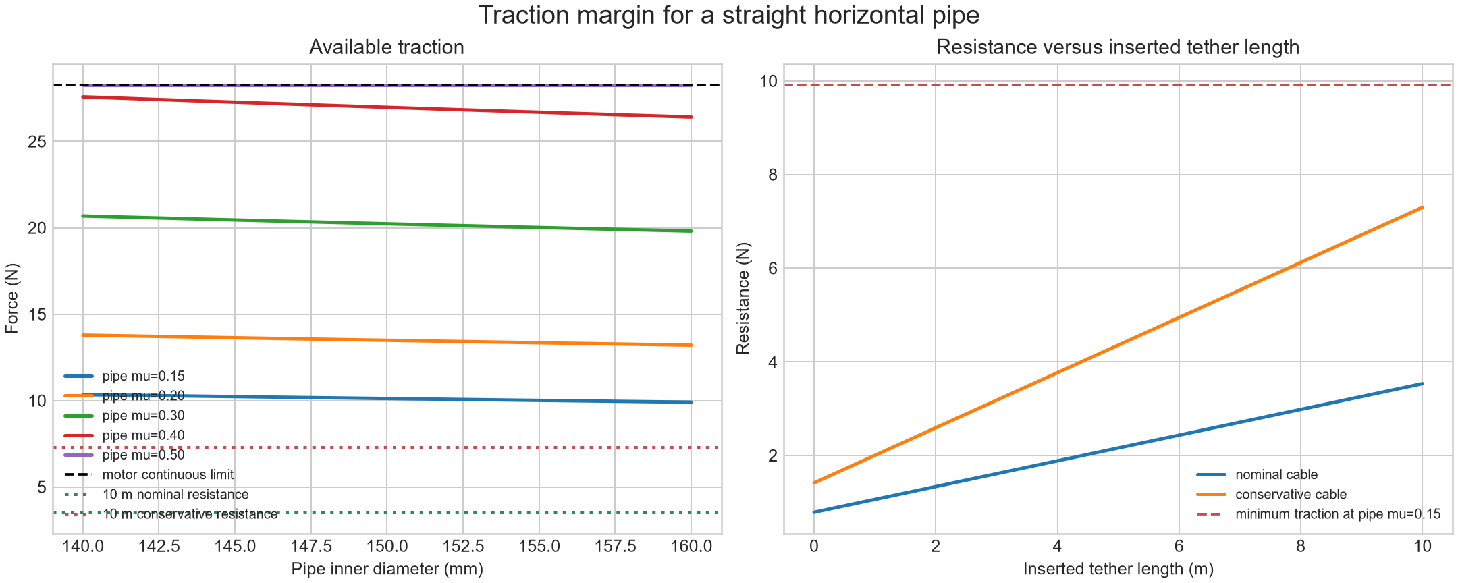
simulation/results/traction_and_tether.png
