A123536/final-report/firmware/Final_project5/Final_project5.ioc

Mcu.UserName=STM32F411CEUx
PA0-WKUP.GPIO_Label=Encoder1.1
PA0-WKUP.Signal=S_TIM2_CH1_ETR
PA1.GPIO_Label=Encoder1.2
PA1.Signal=S_TIM2_CH2
PA10.GPIO_Label=light
PA10.Signal=GPIO_Output
PA13.Signal=SYS_JTMS-SWDIO
PA14.Signal=SYS_JTCK-SWCLK
PA2.Signal=USART2_TX
PA3.Signal=USART2_RX
PA4.Signal=ADCx_IN4
PA5.Signal=ADCx_IN5
PA6.Signal=ADCx_IN6
PA7.Signal=ADCx_IN7
PA8.GPIO_Label=PWM1
PA8.Signal=S_TIM1_CH1
PA9.GPIO_Label=PWM2
PA9.Signal=S_TIM1_CH2
PB0.GPIO_Label=IN2.2
PB0.Signal=GPIO_Output
PB1.GPIO_Label=En
PB1.Signal=GPIO_Output
PB10.GPIO_Label=IN2.1
PB10.Signal=GPIO_Output
PB12.GPIO_Label=CS
PB12.Signal=GPIO_Output
PB13.Signal=SPI2_SCK
PB14.Signal=SPI2_MISO
PB15.Signal=SPI2_MOSI
PB3.GPIO_Label=SF1
PB3.Signal=GPIO_Input
PB4.GPIO_Label=SF2
PB4.Signal=GPIO_Input
PB5.GPIO_Label=RS485_direction_control
PB5.Signal=GPIO_Output
PB6.GPIO_Label=Encoder2.1
PB6.Signal=S_TIM4_CH1
PB7.GPIO_Label=Encoder2.2
PB7.Signal=S_TIM4_CH2
PB8.GPIO_Label=IN1.1
PB8.Signal=GPIO_Output
PB9.GPIO_Label=IN1.2
PB9.Signal=GPIO_Output
PC13-ANTI_TAMP.Signal=GPIO_Output
PC14-OSC32_IN.Signal=RCC_OSC32_IN
PC15-OSC32_OUT.Signal=RCC_OSC32_OUT
