A123536/final-report/firmware/Final_project5/Core/Inc/main.h

#define Encoder1_1_Pin GPIO_PIN_0
#define Encoder1_1_GPIO_Port GPIOA
#define Encoder1_2_Pin GPIO_PIN_1
#define Encoder1_2_GPIO_Port GPIOA
#define IN2_2_Pin GPIO_PIN_0
#define IN2_2_GPIO_Port GPIOB
#define En_Pin GPIO_PIN_1
#define En_GPIO_Port GPIOB
#define IN2_1_Pin GPIO_PIN_10
#define IN2_1_GPIO_Port GPIOB
#define CS_Pin GPIO_PIN_12
#define CS_GPIO_Port GPIOB
#define PWM1_Pin GPIO_PIN_8
#define PWM1_GPIO_Port GPIOA
#define PWM2_Pin GPIO_PIN_9
#define PWM2_GPIO_Port GPIOA
#define light_Pin GPIO_PIN_10
#define light_GPIO_Port GPIOA
#define SF1_Pin GPIO_PIN_3
#define SF1_GPIO_Port GPIOB
#define SF2_Pin GPIO_PIN_4
#define SF2_GPIO_Port GPIOB
#define RS485_direction_control_Pin GPIO_PIN_5
#define RS485_direction_control_GPIO_Port GPIOB
#define Encoder2_1_Pin GPIO_PIN_6
#define Encoder2_1_GPIO_Port GPIOB
#define Encoder2_2_Pin GPIO_PIN_7
#define Encoder2_2_GPIO_Port GPIOB
#define IN1_1_Pin GPIO_PIN_8
#define IN1_1_GPIO_Port GPIOB
#define IN1_2_Pin GPIO_PIN_9
#define IN1_2_GPIO_Port GPIOB
