A123536/final-report/(commit log)

2026-10-11 chore: establish initial project baseline
    [diameter_sweep.csv]
2026-10-13 feat: add SolidWorks concept assembly
    [BearingEnvelope_22x8x7.SLDPRT, Buck24to12_65x42x17.SLDPRT, CableTieBridge_10x76x5.SLDPRT, CameraLensEnvelope_D18_L7.SLDPRT, CenterAxle_D10_L92.SLDPRT, CenterStopTab_12x9x18.SLDPRT, DrivenWheel_D60_W28.SLDPRT, EncoderEnvelope_D33p8_L13p8.SLDPRT]
2026-10-13 fix: normalize SolidWorks harness part names
    [POWER_HARNESS_D4p4_L115p6_0.SLDPRT, POWER_HARNESS_D4p4_L60p4_2.SLDPRT, POWER_HARNESS_D4p4_L61p0_1.SLDPRT, POWER_HARNESS_D4p4_L93p3_3.SLDPRT, SIGNAL_HARNESS_D3p2_L114p4_0.SLDPRT, SIGNAL_HARNESS_D3p2_L64p1_2.SLDPRT, SIGNAL_HARNESS_D3p2_L64p4_1.SLDPRT, SIGNAL_HARNESS_D3p2_L93p3_3.SLDPRT]
2026-10-13 docs: link SolidWorks assembly
2026-10-13 feat: add SolidWorks general arrangement drawing
    [V_Pipe_Robot_Concept_ID150_GA.SLDDRW]
2026-10-13 feat: add portable teacher delivery model
    [V_Pipe_Robot_Concept_ID150.SLDASM, V_Pipe_Robot_Concept_ID150.STEP]
2026-10-18 fix: eliminate SolidWorks packaging interferences
    [Bearing619_8_19x8x6.SLDPRT, BearingEnvelope_22x8x7.SLDPRT, Buck24to12_65x42x17.SLDPRT, CableTieBridge_10x60x5.SLDPRT, CableTieBridge_10x76x5.SLDPRT, CameraLensEnvelope_D18_L7.SLDPRT, CenterAxle_D10_L92.SLDPRT, CenterAxle_D8_L92.SLDPRT]
2026-10-22 feat: split printable PETG enclosures and add assembly drawings
    [Bearing619_8_19x8x6.SLDPRT, Buck24to12_65x42x17.SLDPRT, CableTieBridge_10x60x5.SLDPRT, CameraHousing_Body_50x48x32_t2.SLDPRT, CameraHousing_FrontBezel_48x32x2p4_D19p5.SLDPRT, CameraLensEnvelope_D18_L7.SLDPRT, CenterAxle_D8_L92.SLDPRT, CenterStopTab_12x6x12.SLDPRT]
2026-10-28 docs: add complete procurement list with wired vision selection
    [V型管道机器人_完整采购清单_含视觉_2026-10-28.xlsx]
2026-10-28 docs: illustrate all 87 procurement items and assembly relationships
2026-11-03 feat: adopt supplied 2026-10-13 model as current baseline
    [Bearing619_8_19x8x6.SLDPRT, BearingEnvelope_22x8x7.SLDPRT, Buck24to12_65x42x17.SLDPRT, CableTieBridge_10x60x5.SLDPRT, CableTieBridge_10x76x5.SLDPRT, CameraHousing_Body_50x48x32_t2.SLDPRT, CameraHousing_FrontBezel_48x32x2p4_D19p5.SLDPRT, CameraLensEnvelope_D18_L7.SLDPRT]
2026-11-04 docs: add center joint angle sensor integration plan
2026-11-06 feat: archive configured STM32F411 FreeRTOS project snapshot
